luizf0120/database-migration-schema-temporary-holding/artilharia/corte_cunha.png

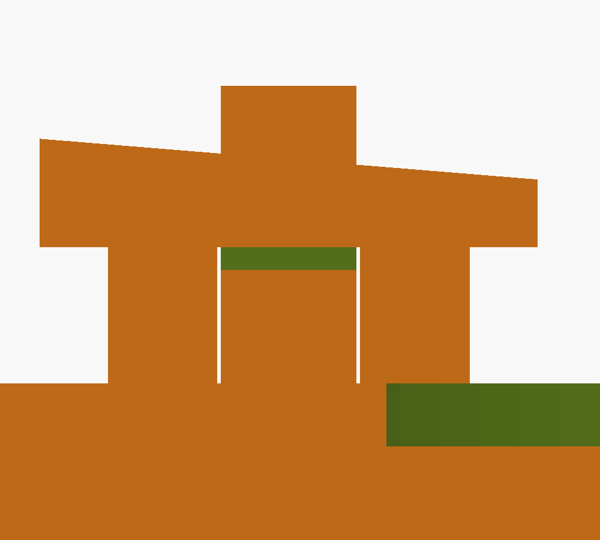
artilharia/corte_cunha.png
