luizf0120/database-migration-schema-temporary-holding/artilharia/detalhe_elevacao.png

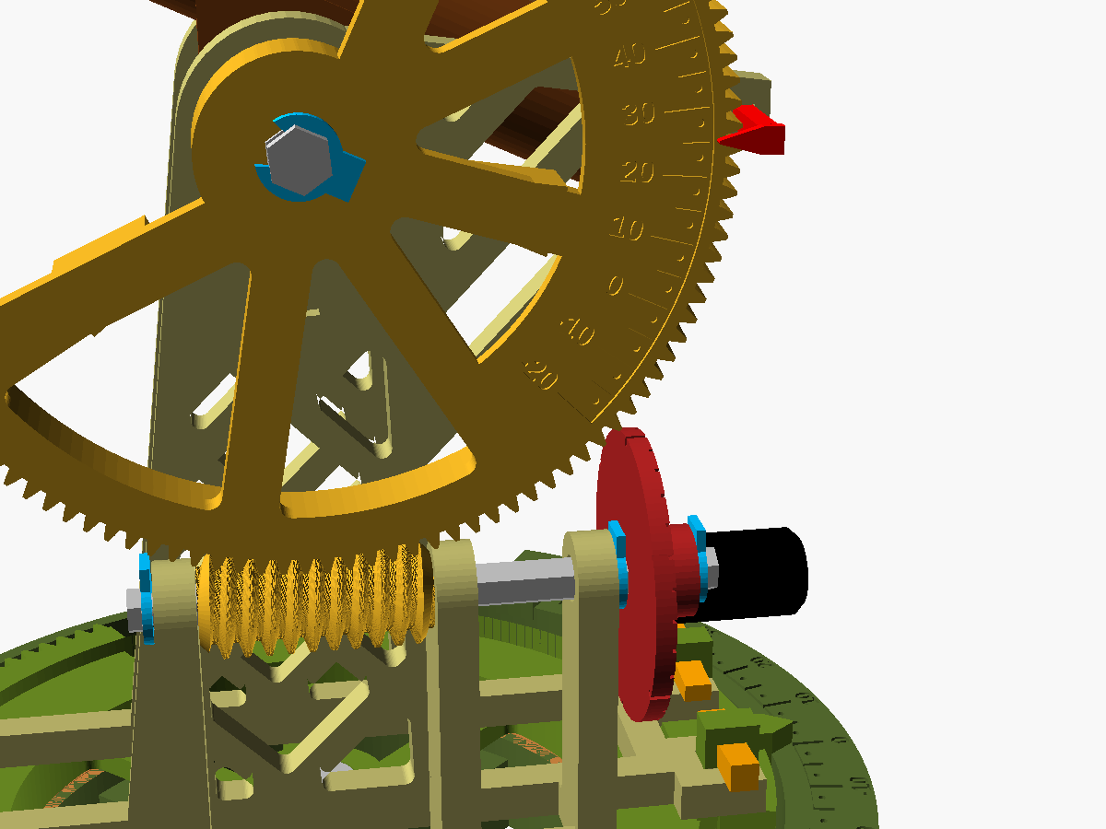
artilharia/detalhe_elevacao.png
