luizf0120/database-migration-schema-temporary-holding/artilharia/numeros_avulsos.png

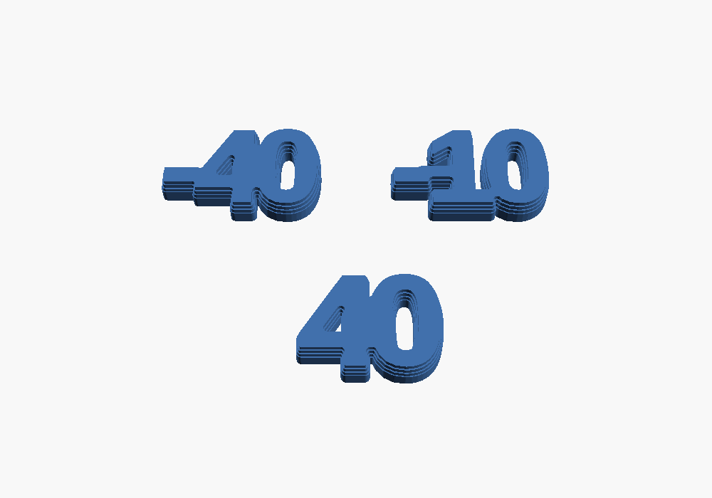
artilharia/numeros_avulsos.png
