luizf0120/database-migration-schema-temporary-holding/artilharia/rolamento_explodido.png

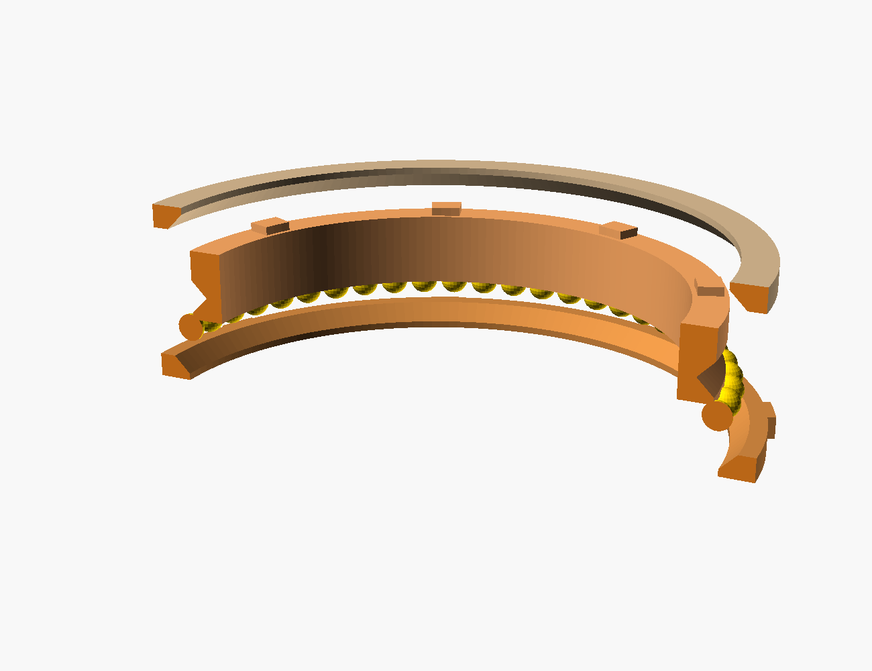
artilharia/rolamento_explodido.png
