luizf0120/database-migration-schema-temporary-holding/artilharia/stl/numeros_avulsos.stl

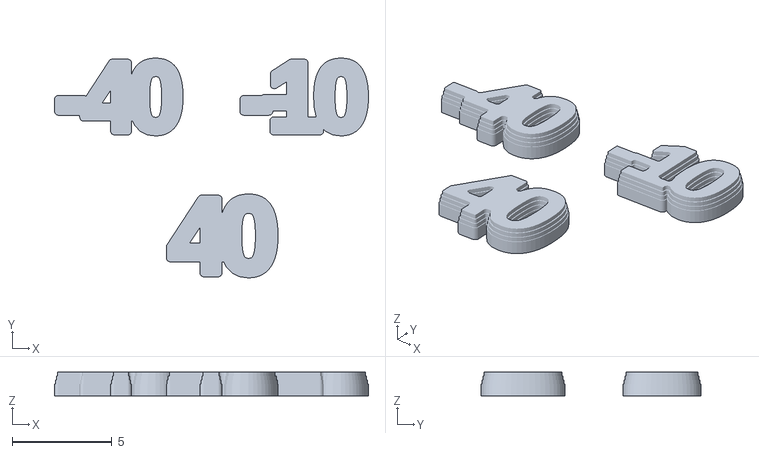
[picture p18: CAD file, 2026-11-08]
artilharia/stl/numeros_avulsos.stl
15.7 x 11.0 x 1.20
