luizf0120/database-migration-schema-temporary-holding/artilharia/stl/numeros_az.stl

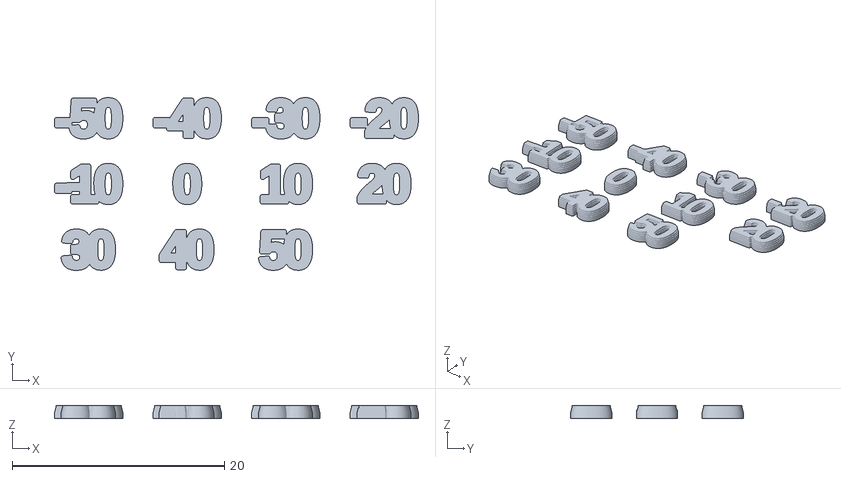
[picture p19: CAD file, 2026-11-06]
artilharia/stl/numeros_az.stl
34.3 x 16.3 x 1.20
