luizf0120/database-migration-schema-temporary-holding/artilharia/stl/numeros_el.stl

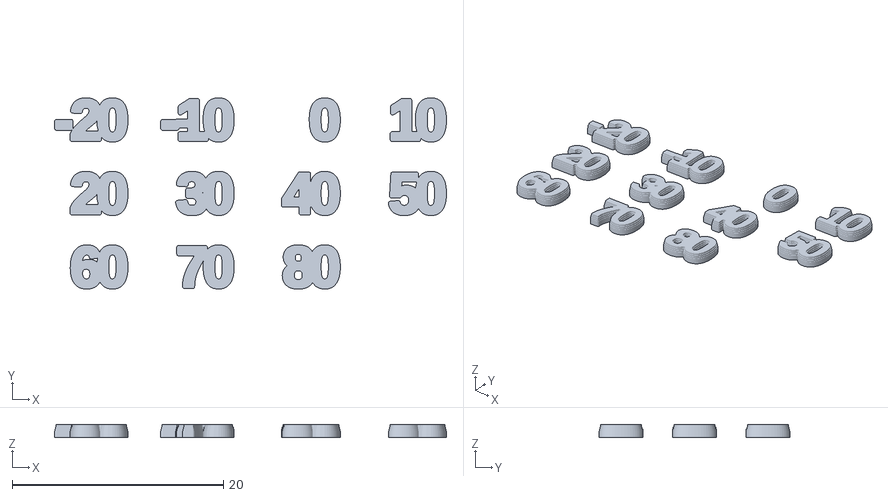
[picture p20: CAD file, 2026-11-06]
artilharia/stl/numeros_el.stl
37.1 x 18.1 x 1.20
