luizf0120/database-migration-schema-temporary-holding/artilharia/stl/regua_el.stl

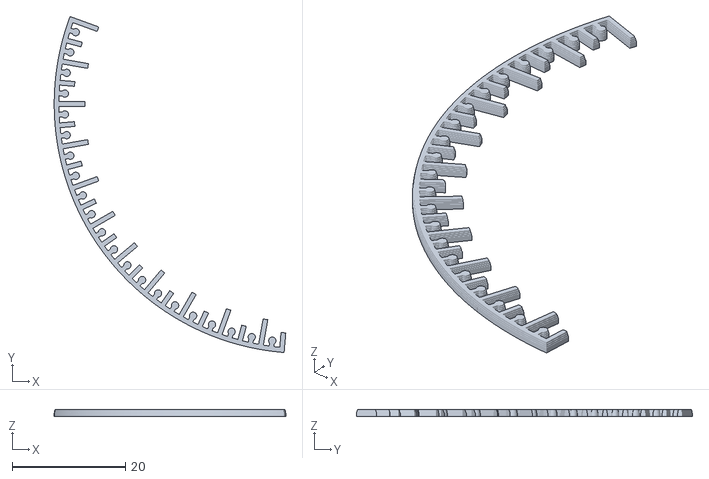
[picture p21: CAD file, 2026-11-06]
artilharia/stl/regua_el.stl
41.0 x 59.5 x 1.20
