luizf0120/database-migration-schema-temporary-holding/artilharia/stl/regua_az.stl

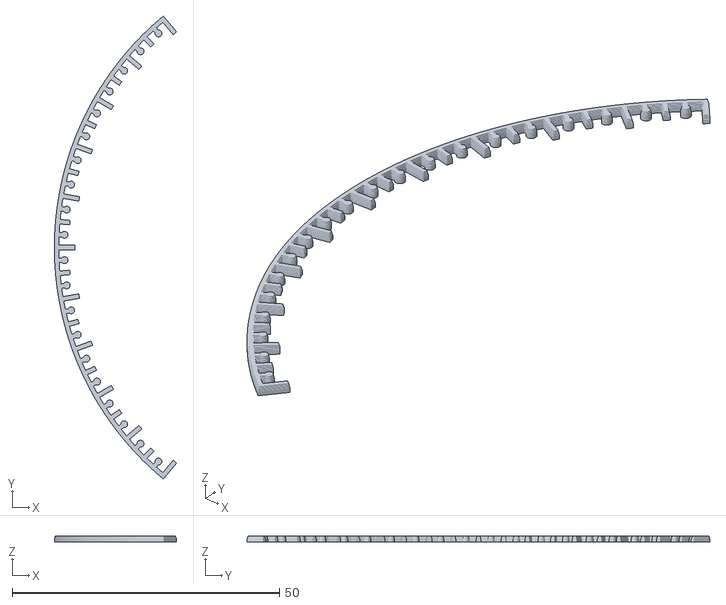
[picture p22: CAD file, 2026-11-06]
artilharia/stl/regua_az.stl
22.9 x 86.6 x 1.20
