luizf0120/database-migration-schema-temporary-holding/artilharia/stl/calco_ponteiro.stl

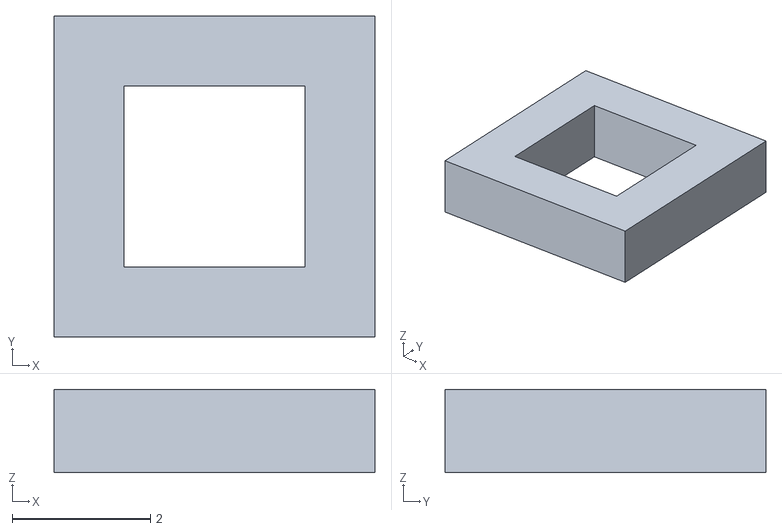
[picture p23: CAD file, 2026-11-06]
artilharia/stl/calco_ponteiro.stl
4.64 x 4.64 x 1.20
