luizf0120/database-migration-schema-temporary-holding/artilharia/stl/anel_reparo.stl

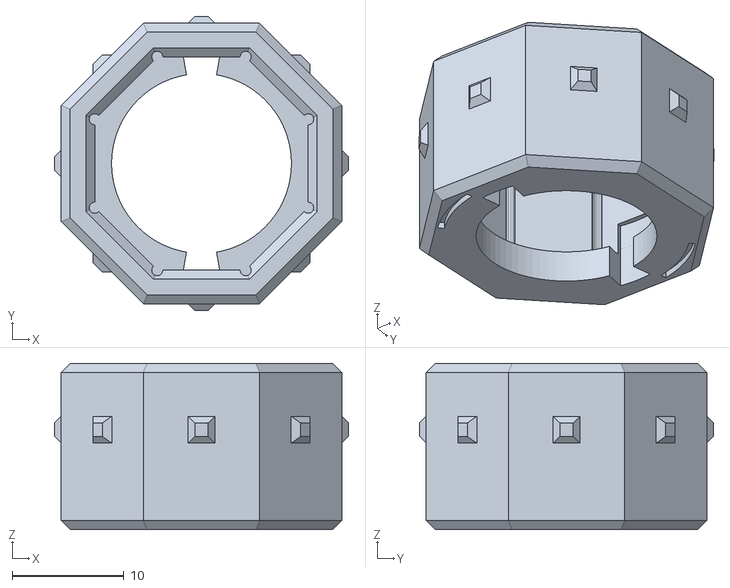
[picture p24: CAD file, 2026-11-05]
artilharia/stl/anel_reparo.stl
26.3 x 26.3 x 14.9
