luizf0120/database-migration-schema-temporary-holding/artilharia/stl/travessa_carro.stl

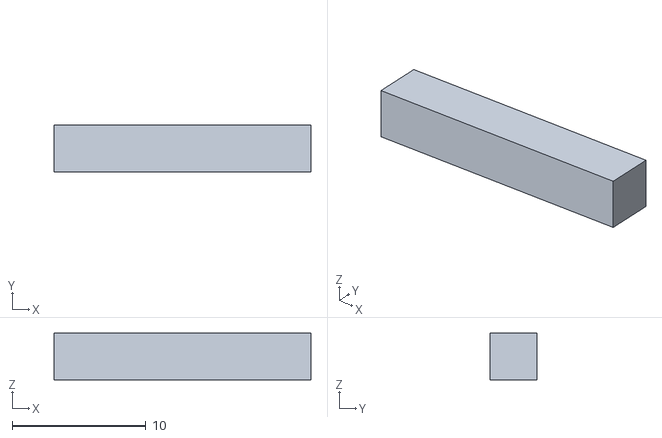
[picture p25: CAD file, 2026-11-04]
artilharia/stl/travessa_carro.stl
19.2 x 3.48 x 3.48
