luizf0120/database-migration-schema-temporary-holding/artilharia/stl/culatra.stl

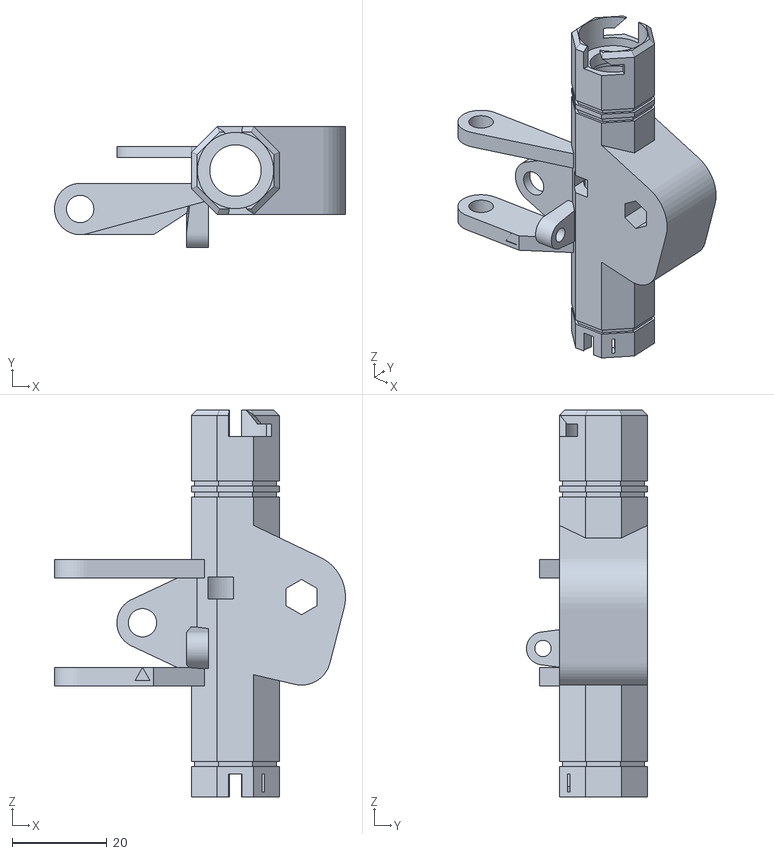
[picture p26: CAD file, 2026-11-03]
artilharia/stl/culatra.stl
61.3 x 25.5 x 81.6
