luizf0120/database-migration-schema-temporary-holding/artilharia/stl/carro.stl

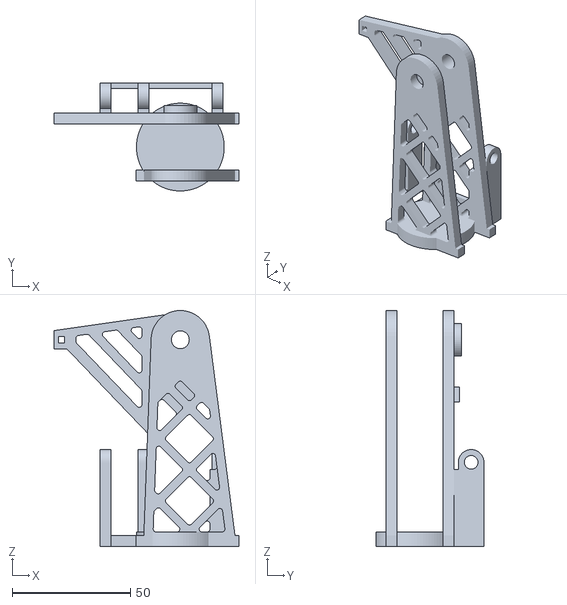
[picture p27: CAD file, 2026-11-03]
artilharia/stl/carro.stl
78.1 x 45.6 x 99.7
