luizf0120/database-migration-schema-temporary-holding/artilharia/stl/eixo_pinhao.stl

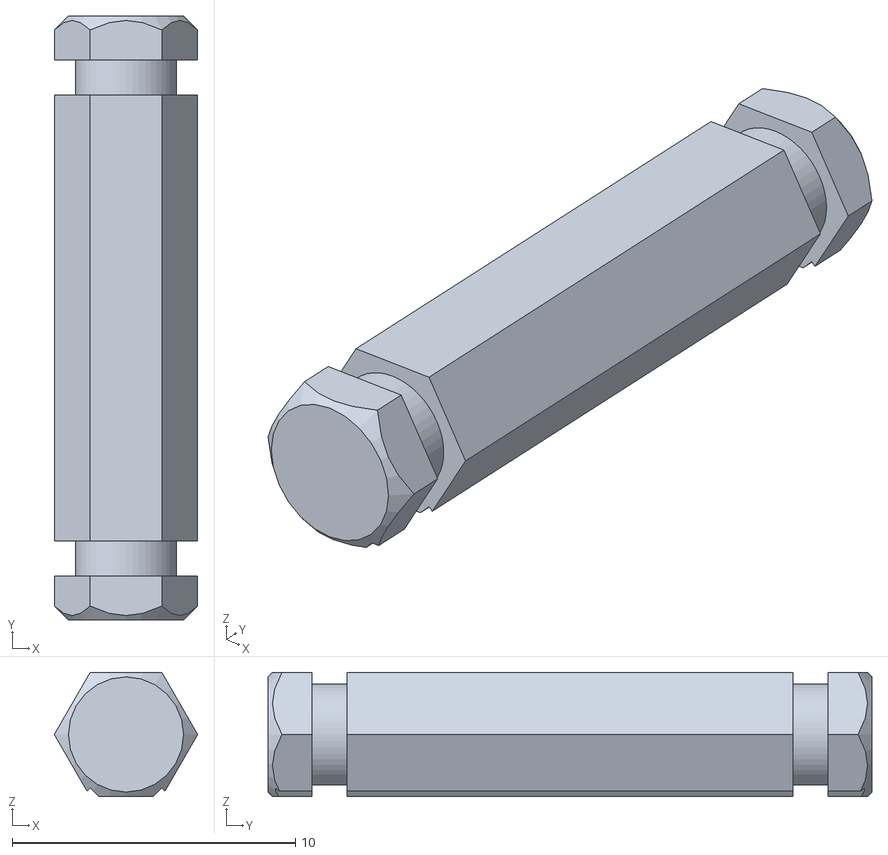
[picture p28: CAD file, 2026-11-03]
artilharia/stl/eixo_pinhao.stl
5.07 x 21.3 x 4.39
