luizf0120/database-migration-schema-temporary-holding/artilharia/stl/cano.stl

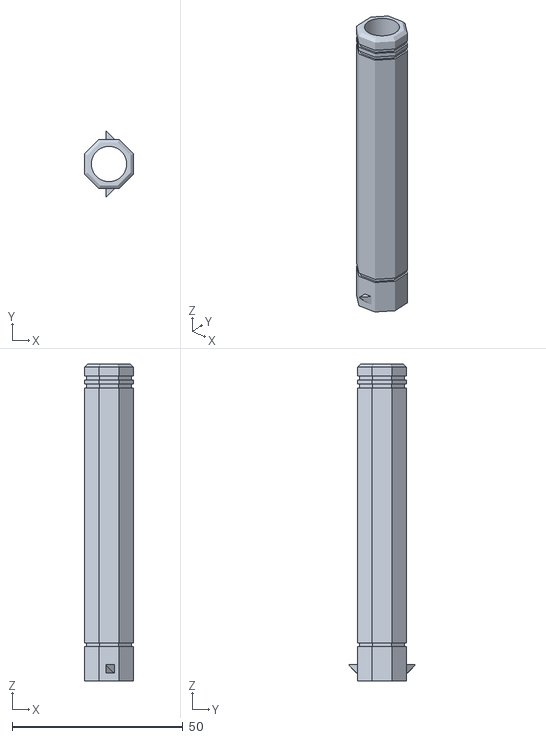
[picture p29: CAD file, 2026-11-03]
artilharia/stl/cano.stl
14.4 x 19.3 x 92.8
