luizf0120/database-migration-schema-temporary-holding/artilharia/stl/amortecedor.stl

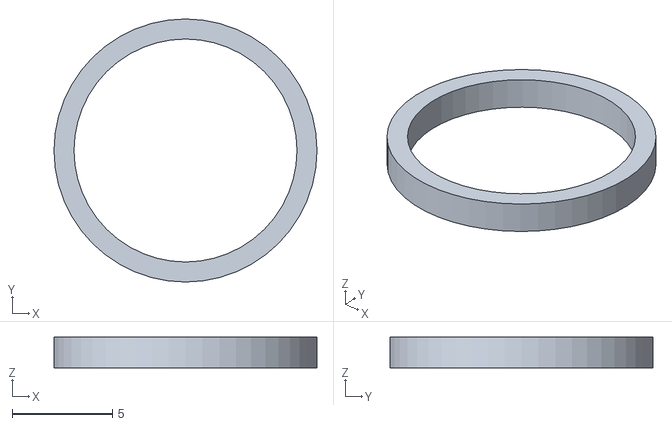
[picture p30: CAD file, 2026-11-03]
artilharia/stl/amortecedor.stl
13.1 x 13.1 x 1.55
