luizf0120/database-migration-schema-temporary-holding/artilharia/stl/ponteiro_el.stl

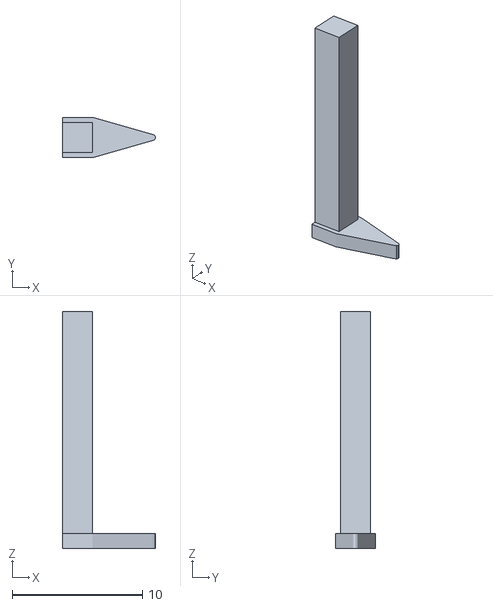
[picture p31: CAD file, 2026-11-03]
artilharia/stl/ponteiro_el.stl
7.15 x 3.09 x 18.2
