luizf0120/database-migration-schema-temporary-holding/artilharia/stl/pino_pivo.stl

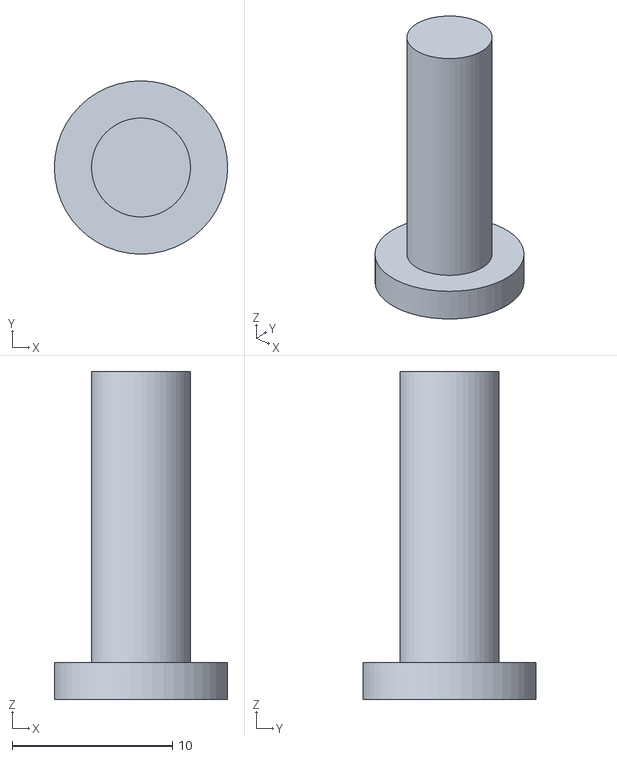
[picture p32: CAD file, 2026-11-03]
artilharia/stl/pino_pivo.stl
10.8 x 10.8 x 20.5
