luizf0120/database-migration-schema-temporary-holding/artilharia/stl/tampa.stl

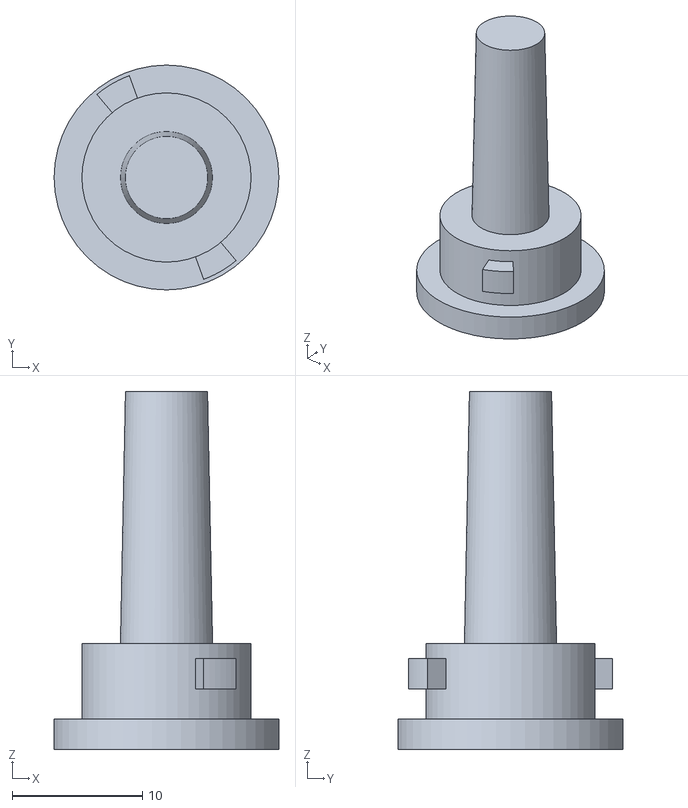
[picture p33: CAD file, 2026-11-03]
artilharia/stl/tampa.stl
17.2 x 17.2 x 27.4
