luizf0120/database-migration-schema-temporary-holding/artilharia/stl/pino_gatilho.stl

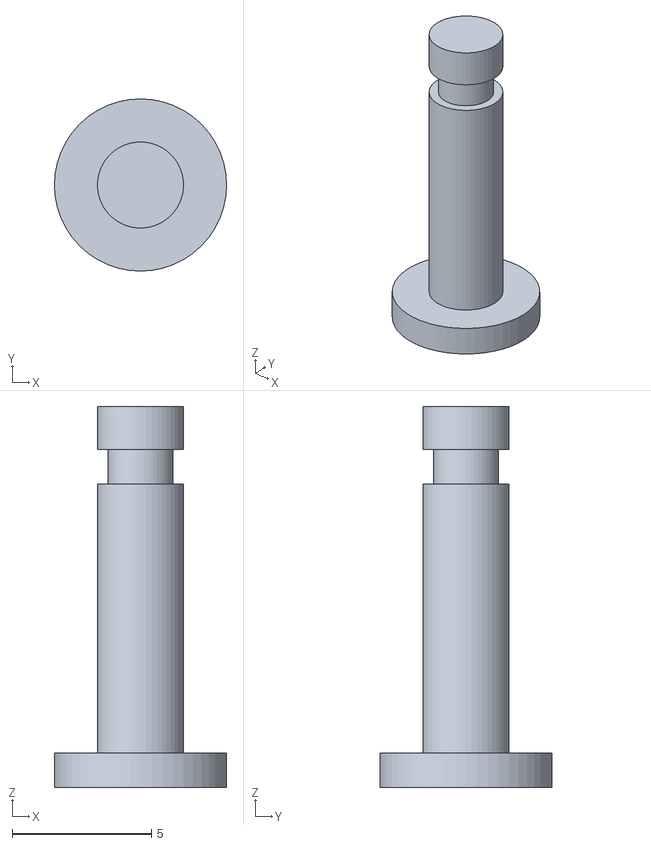
[picture p34: CAD file, 2026-11-02]
artilharia/stl/pino_gatilho.stl
6.19 x 6.19 x 13.7
