luizf0120/database-migration-schema-temporary-holding/artilharia/stl/eixo_az.stl

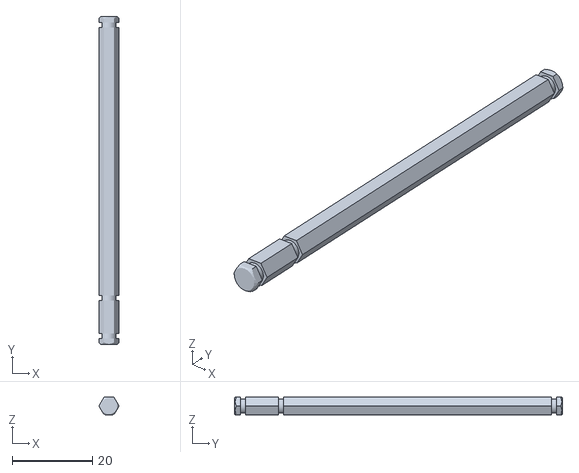
[picture p35: CAD file, 2026-10-31]
artilharia/stl/eixo_az.stl
5.07 x 82.0 x 4.39
