luizf0120/database-migration-schema-temporary-holding/artilharia/stl/eixo_munhao.stl

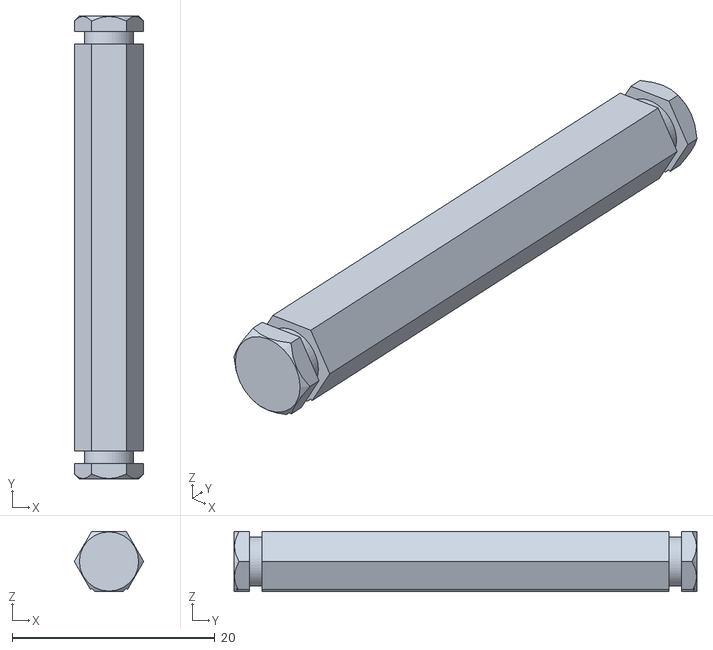
[picture p36: CAD file, 2026-10-31]
artilharia/stl/eixo_munhao.stl
6.85 x 45.7 x 5.94
