luizf0120/database-migration-schema-temporary-holding/artilharia/stl/soquete.stl

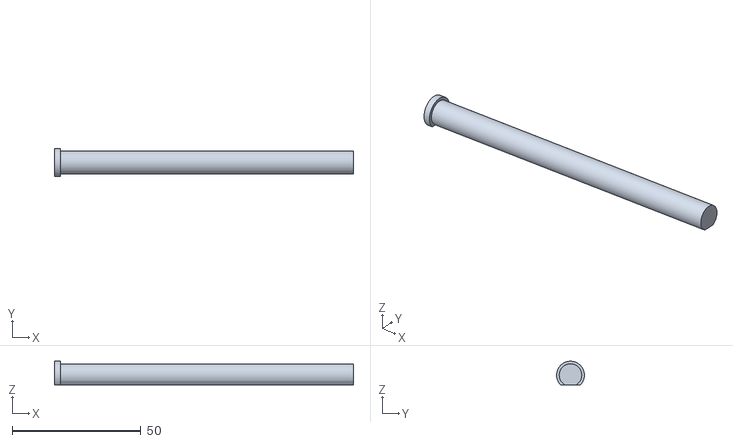
[picture p37: CAD file, 2026-10-31]
artilharia/stl/soquete.stl
116.0 x 10.8 x 9.19
