luizf0120/database-migration-schema-temporary-holding/artilharia/stl/eixo_armar.stl

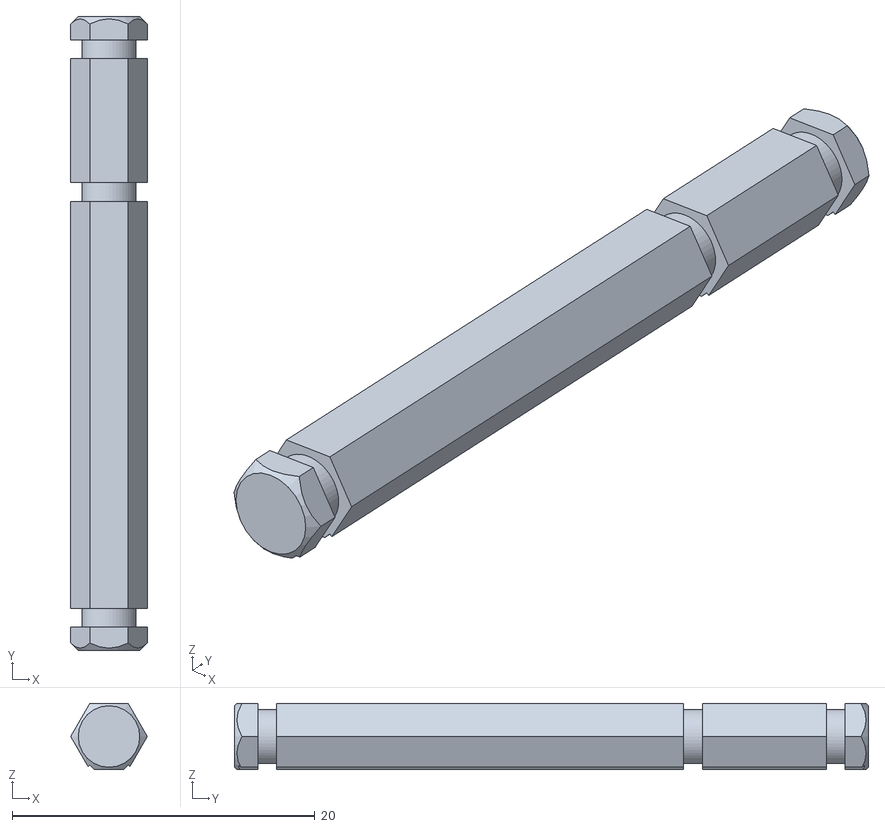
[picture p38: CAD file, 2026-10-31]
artilharia/stl/eixo_armar.stl
5.07 x 41.9 x 4.39
