luizf0120/database-migration-schema-temporary-holding/artilharia/stl/gatilho.stl

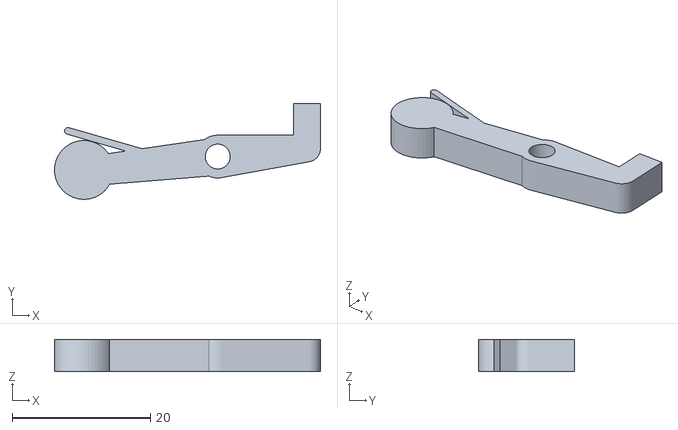
[picture p39: CAD file, 2026-10-31]
artilharia/stl/gatilho.stl
38.4 x 13.8 x 4.64
