luizf0120/database-migration-schema-temporary-holding/artilharia/stl/eixo_el.stl

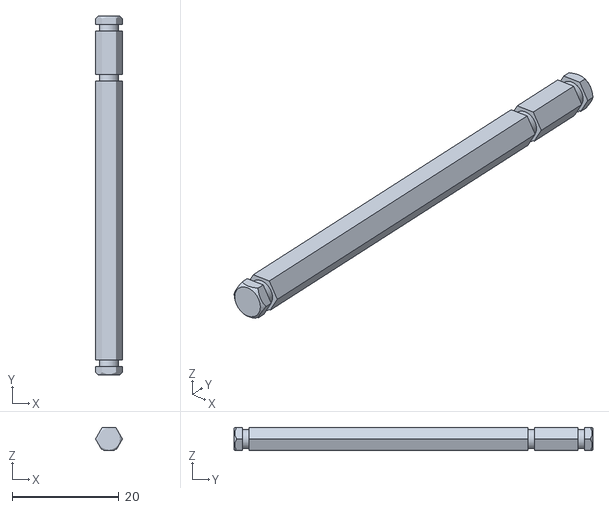
[picture p40: CAD file, 2026-10-31]
artilharia/stl/eixo_el.stl
5.07 x 67.3 x 4.39
