luizf0120/database-migration-schema-temporary-holding/artilharia/stl/ponteiro_az.stl

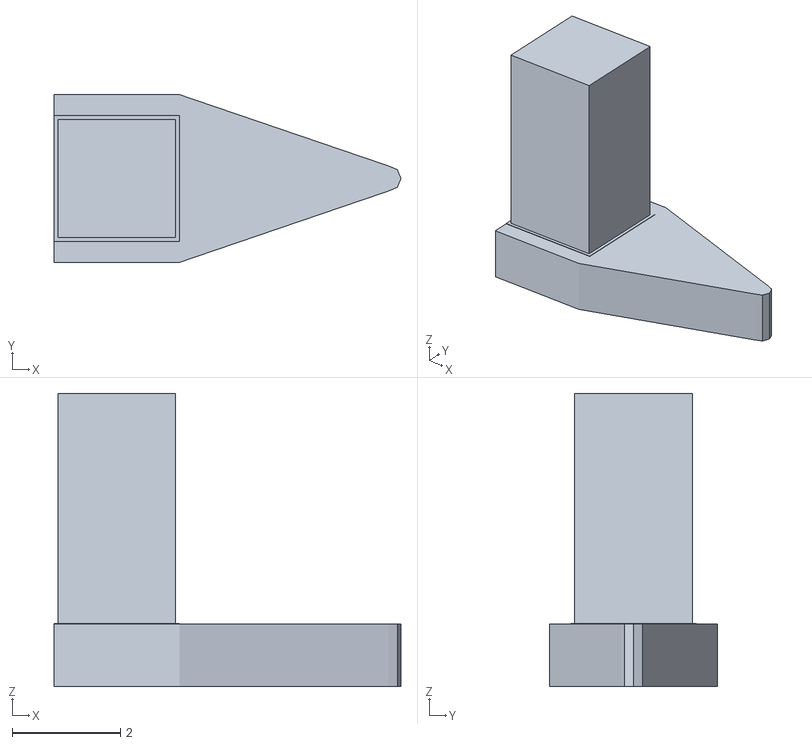
[picture p41: CAD file, 2026-10-31]
artilharia/stl/ponteiro_az.stl
6.40 x 3.09 x 5.41
