luizf0120/database-migration-schema-temporary-holding/artilharia/stl/culatra_cima.stl

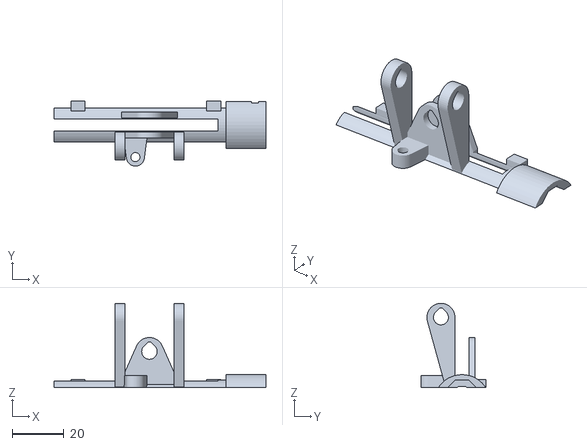
[picture p42: CAD file, 2026-10-30]
artilharia/stl/culatra_cima.stl
81.6 x 25.1 x 32.5
