luizf0120/database-migration-schema-temporary-holding/artilharia/stl/culatra_baixo.stl

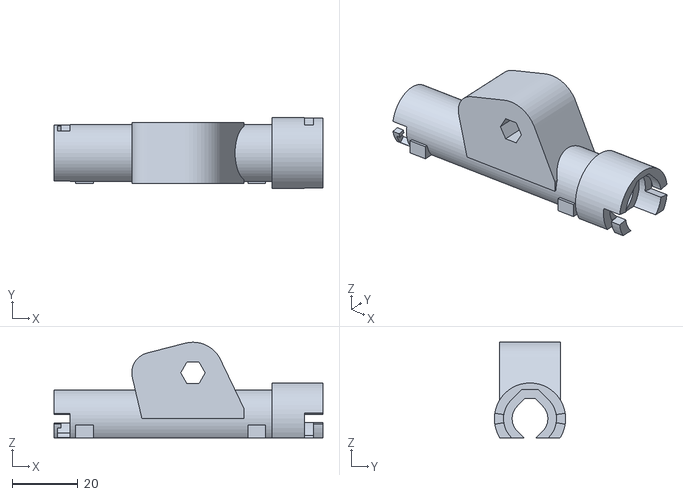
[picture p43: CAD file, 2026-10-30]
artilharia/stl/culatra_baixo.stl
81.6 x 21.6 x 29.0
