luizf0120/database-migration-schema-temporary-holding/artilharia/stl/trava_4.stl

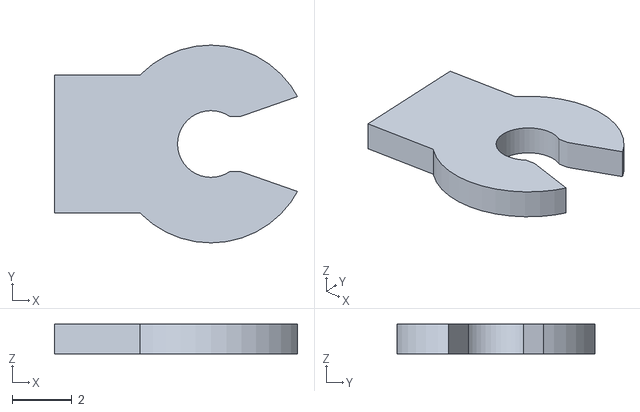
[picture p44: CAD file, 2026-10-25]
artilharia/stl/trava_4.stl
8.17 x 6.65 x 1.00
