luizf0120/database-migration-schema-temporary-holding/artilharia/stl/trava_8.stl

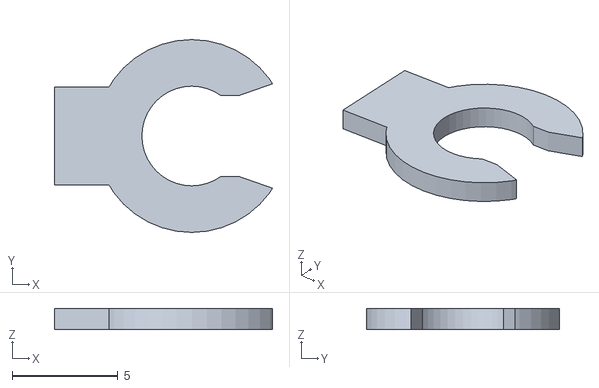
[picture p45: CAD file, 2026-10-25]
artilharia/stl/trava_8.stl
10.3 x 9.12 x 1.00
