luizf0120/database-migration-schema-temporary-holding/artilharia/stl/trava_6.stl

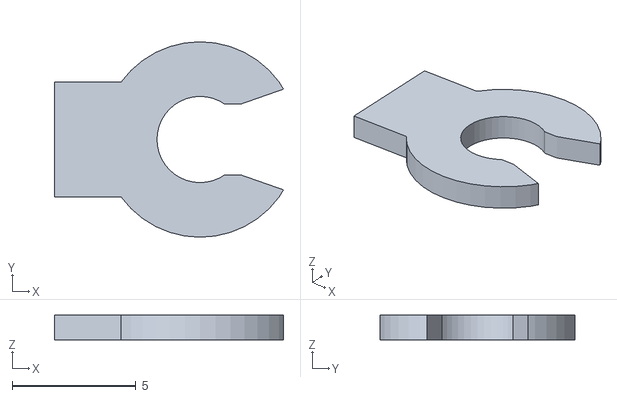
[picture p46: CAD file, 2026-10-25]
artilharia/stl/trava_6.stl
9.24 x 7.89 x 1.00
