luizf0120/database-migration-schema-temporary-holding/artilharia/stl/roda_el.stl

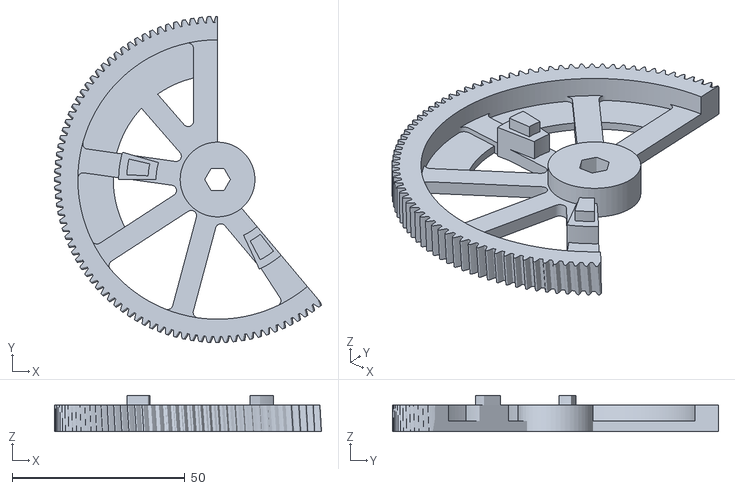
[picture p47: CAD file, 2026-10-24]
artilharia/stl/roda_el.stl
77.2 x 94.3 x 10.4
