luizf0120/database-migration-schema-temporary-holding/artilharia/stl/manivela_el.stl

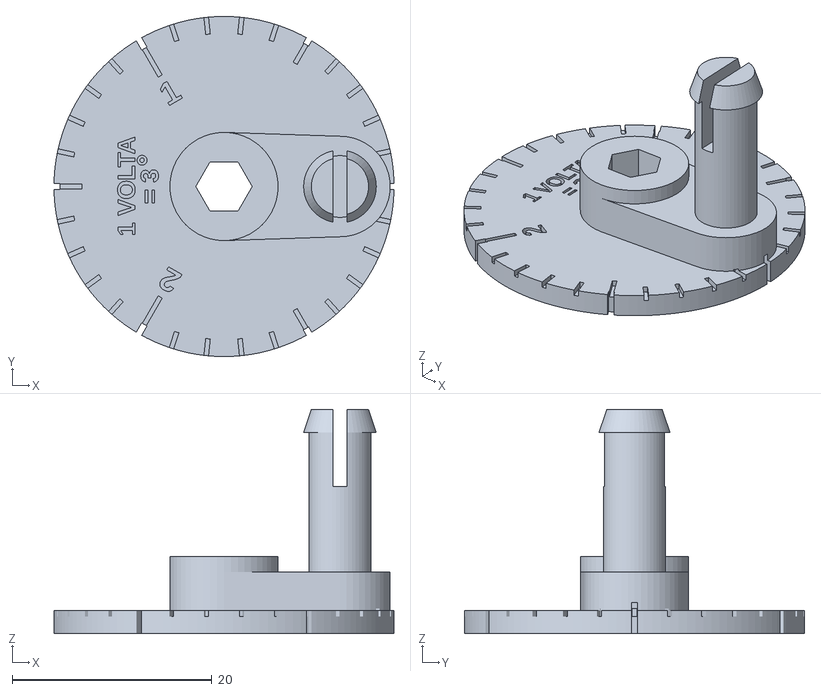
[picture p48: CAD file, 2026-10-24]
artilharia/stl/manivela_el.stl
34.0 x 34.0 x 22.4
