luizf0120/database-migration-schema-temporary-holding/artilharia/stl/rosca_armar.stl

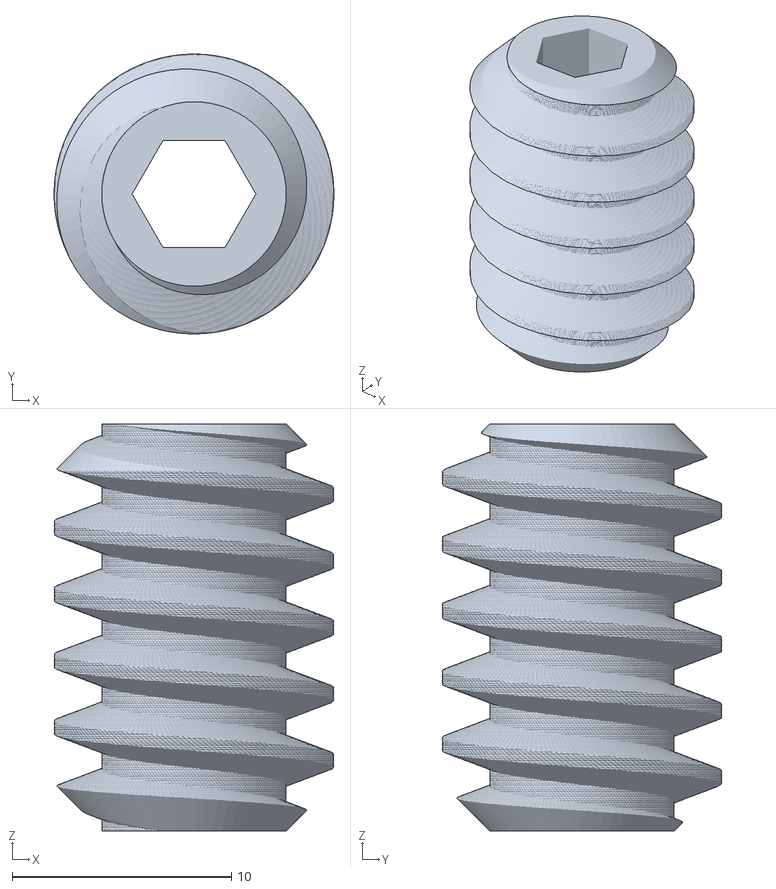
[picture p49: CAD file, 2026-10-24]
artilharia/stl/rosca_armar.stl
12.8 x 12.8 x 18.6
