luizf0120/database-migration-schema-temporary-holding/artilharia/stl/anel_externo_baixo.stl

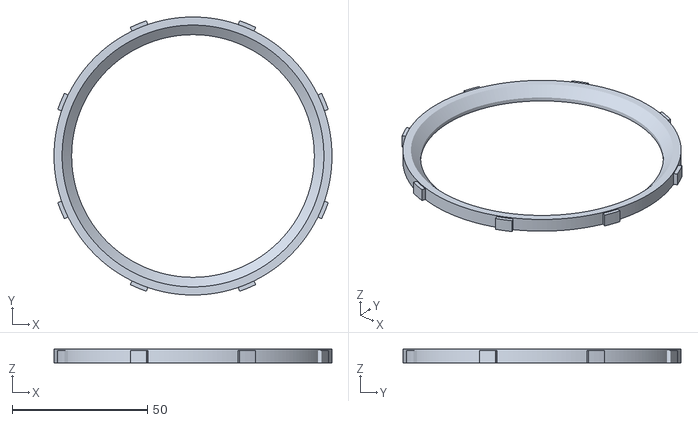
[picture p50: CAD file, 2026-10-24]
artilharia/stl/anel_externo_baixo.stl
102.8 x 102.8 x 5.00
