luizf0120/database-migration-schema-temporary-holding/artilharia/stl/porta_projeteis.stl

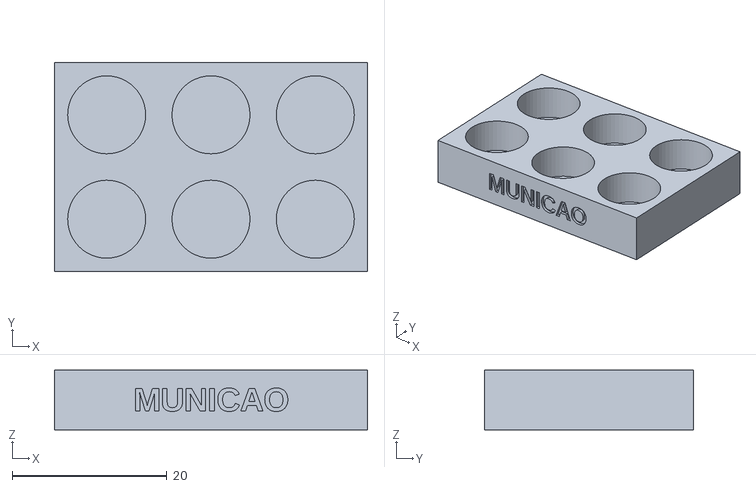
[picture p52: CAD file, 2026-10-24]
artilharia/stl/porta_projeteis.stl
40.4 x 26.9 x 7.73
