luizf0120/database-migration-schema-temporary-holding/artilharia/stl/mesa.stl

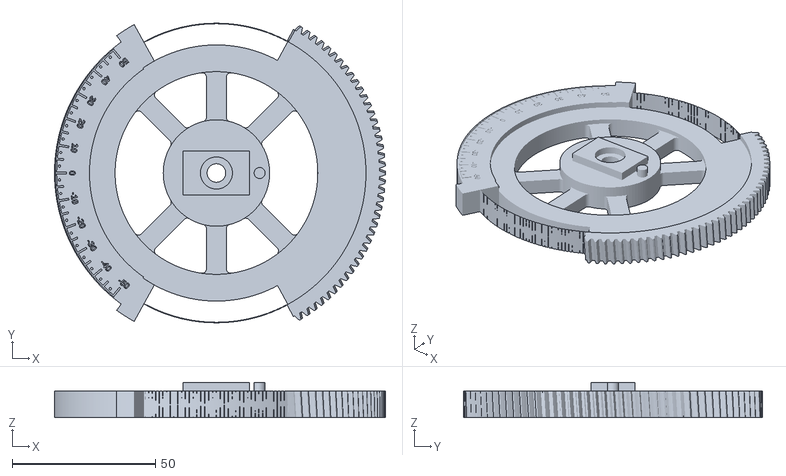
[picture p53: CAD file, 2026-10-24]
artilharia/stl/mesa.stl
115.4 x 104.3 x 12.4
