luizf0120/database-migration-schema-temporary-holding/artilharia/stl/pistao.stl

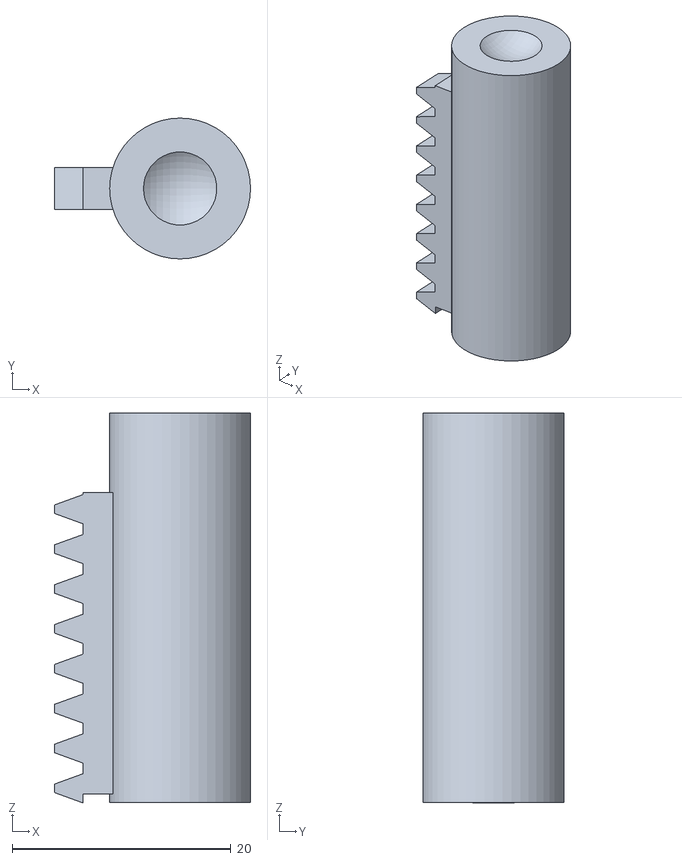
[picture p54: CAD file, 2026-10-24]
artilharia/stl/pistao.stl
17.9 x 12.9 x 35.6
