luizf0120/database-migration-schema-temporary-holding/artilharia/stl/pinhao_armar.stl

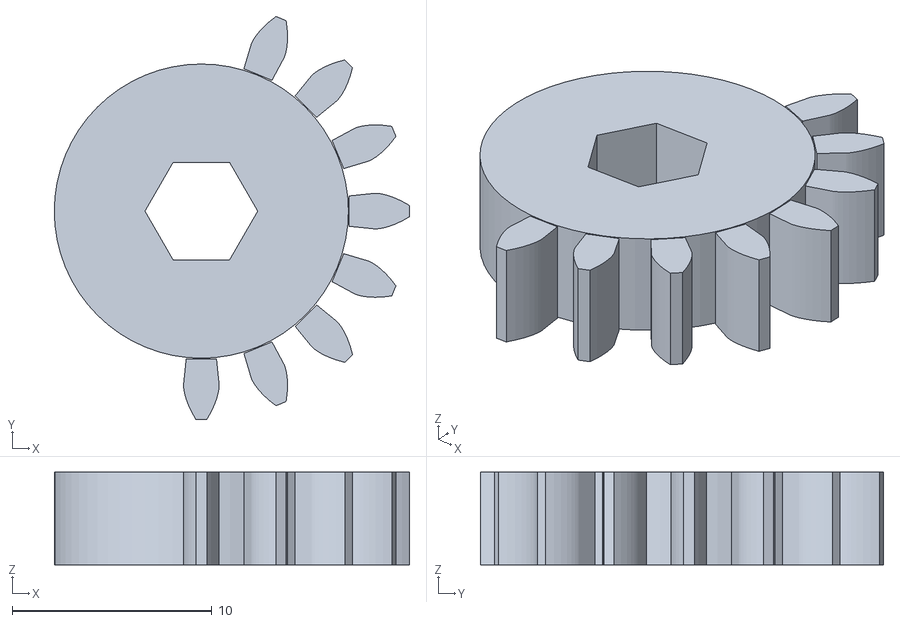
[picture p55: CAD file, 2026-10-24]
artilharia/stl/pinhao_armar.stl
17.8 x 20.2 x 4.64
