luizf0120/database-migration-schema-temporary-holding/artilharia/stl/punho_armar.stl

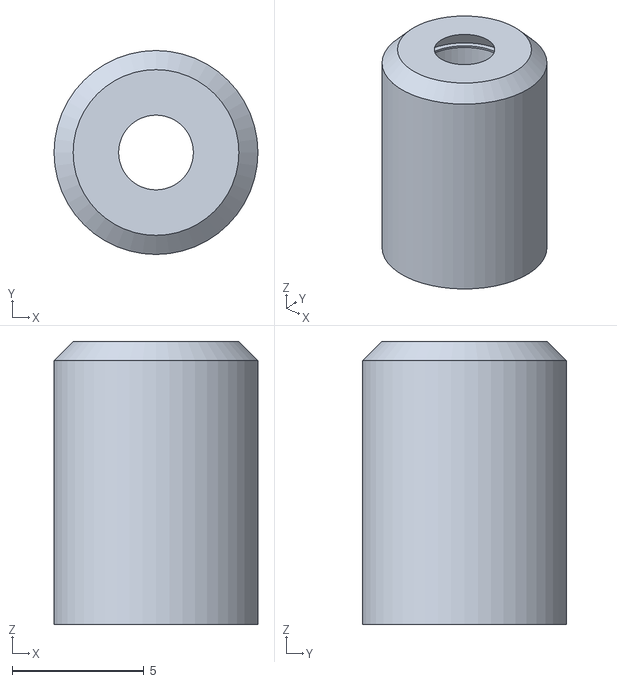
[picture p56: CAD file, 2026-10-24]
artilharia/stl/punho_armar.stl
7.73 x 7.73 x 10.7
