luizf0120/database-migration-schema-temporary-holding/artilharia/stl/coroa_armar.stl

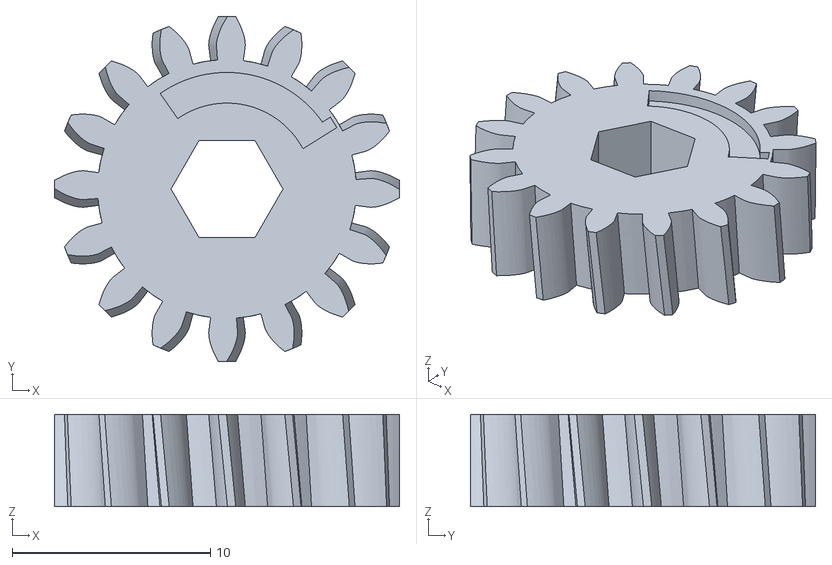
[picture p57: CAD file, 2026-10-24]
artilharia/stl/coroa_armar.stl
17.4 x 17.4 x 4.64
