luizf0120/database-migration-schema-temporary-holding/artilharia/stl/volante_armar.stl

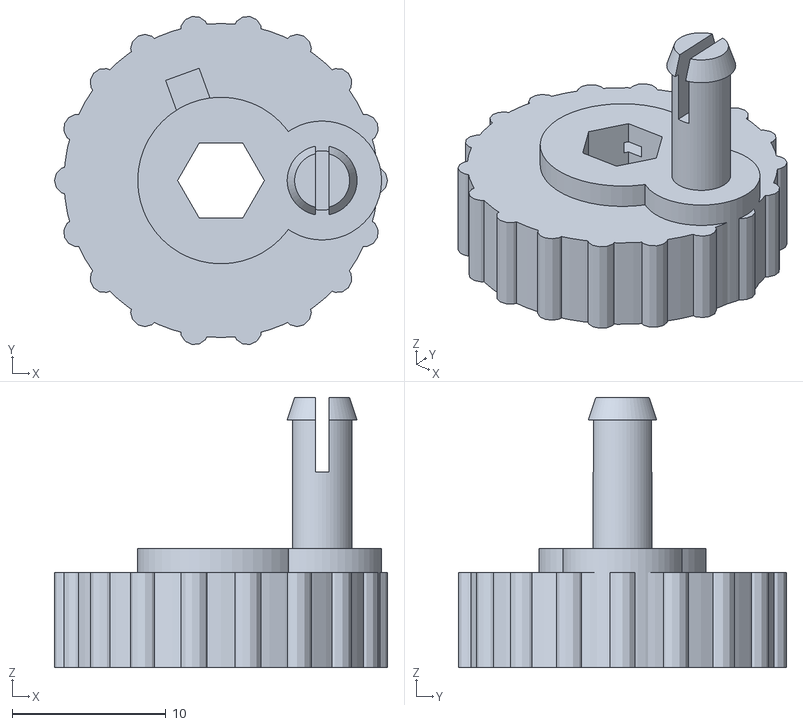
[picture p58: CAD file, 2026-10-24]
artilharia/stl/volante_armar.stl
21.6 x 21.3 x 17.6
