luizf0120/database-migration-schema-temporary-holding/artilharia/stl/projetil.stl

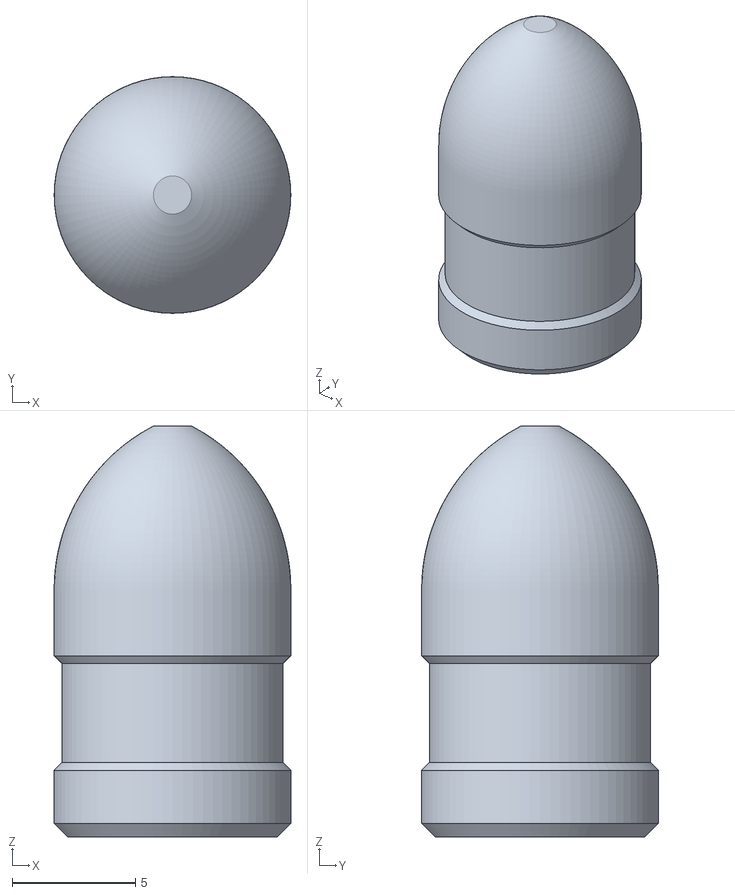
[picture p59: CAD file, 2026-10-24]
artilharia/stl/projetil.stl
9.60 x 9.60 x 16.7
