luizf0120/database-migration-schema-temporary-holding/artilharia/stl/projetil_meio.stl

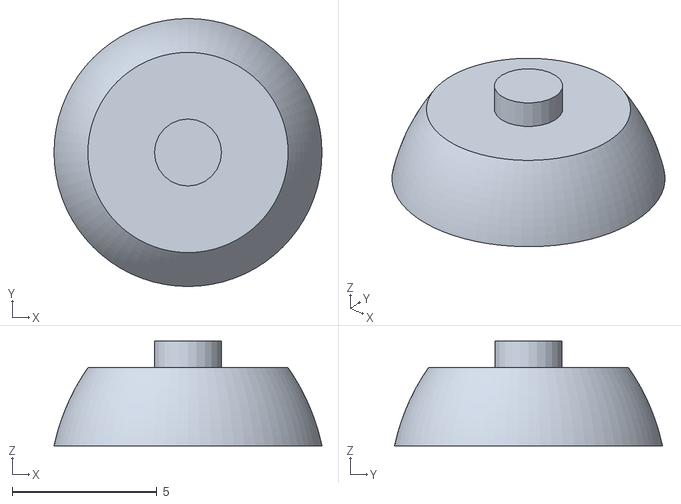
[picture p60: CAD file, 2026-10-24]
artilharia/stl/projetil_meio.stl
9.27 x 9.27 x 3.63
