luizf0120/database-migration-schema-temporary-holding/artilharia/stl/projetil_anel.stl

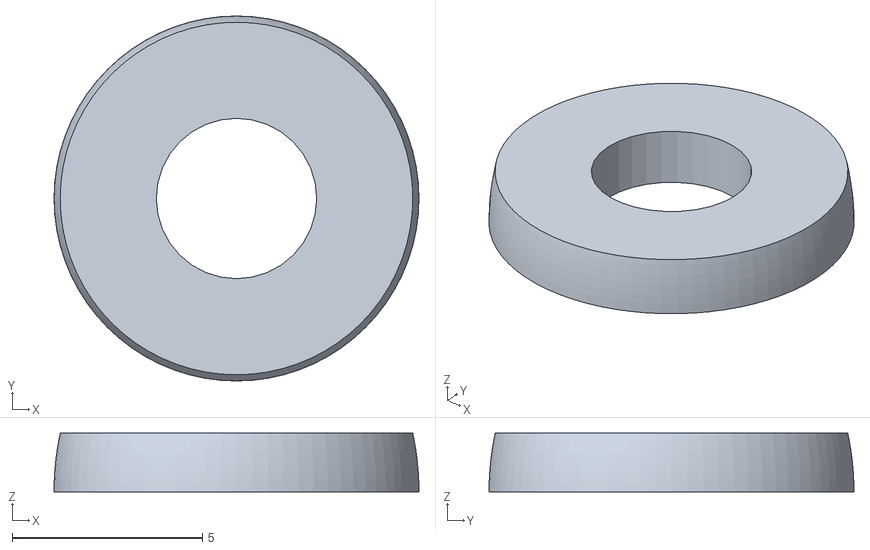
[picture p61: CAD file, 2026-10-24]
artilharia/stl/projetil_anel.stl
9.60 x 9.60 x 1.55
