luizf0120/database-migration-schema-temporary-holding/artilharia/stl/projetil_ponta.stl

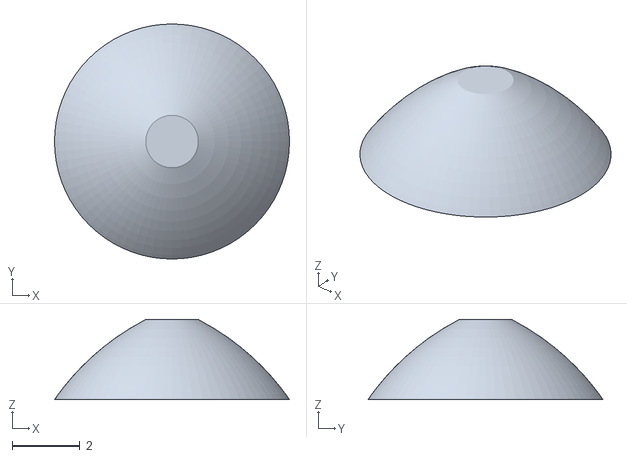
[picture p62: CAD file, 2026-10-24]
artilharia/stl/projetil_ponta.stl
6.92 x 6.92 x 2.36
