luizf0120/database-migration-schema-temporary-holding/artilharia/stl/projetil_corpo.stl

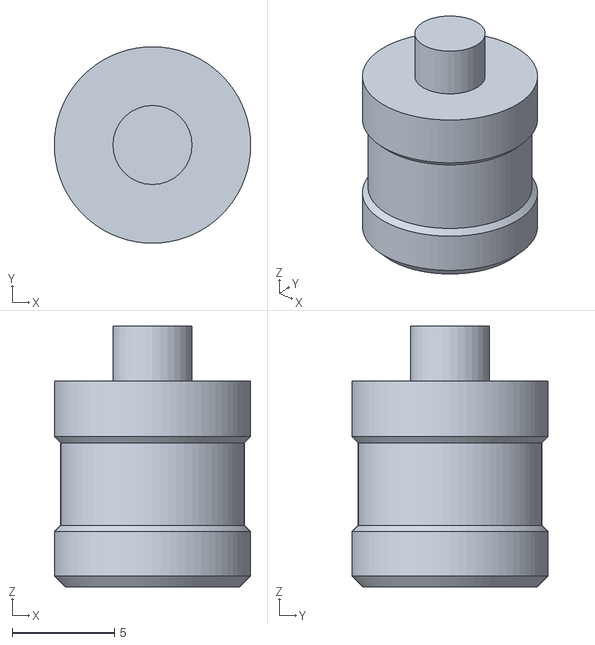
[picture p63: CAD file, 2026-10-24]
artilharia/stl/projetil_corpo.stl
9.60 x 9.60 x 12.8
