luizf0120/database-migration-schema-temporary-holding/artilharia/stl/rosca_el.stl

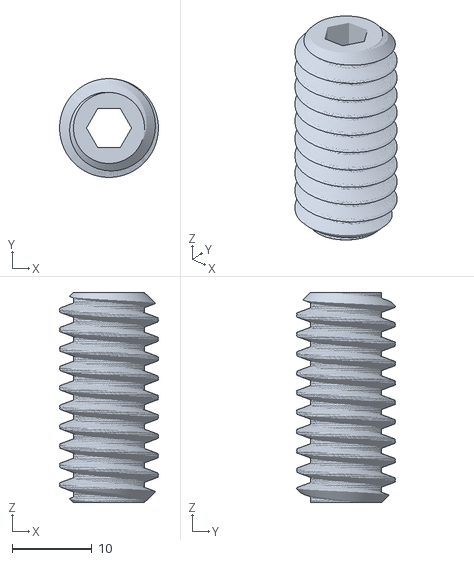
[picture p64: CAD file, 2026-10-24]
artilharia/stl/rosca_el.stl
12.4 x 12.4 x 26.3
