luizf0120/database-migration-schema-temporary-holding/artilharia/stl/anel_interno.stl

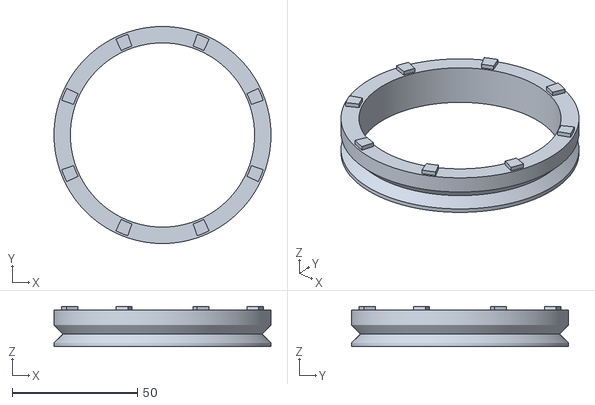
[picture p65: CAD file, 2026-10-24]
artilharia/stl/anel_interno.stl
86.5 x 86.5 x 16.0
