luizf0120/database-migration-schema-temporary-holding/artilharia/stl/rosca_az.stl

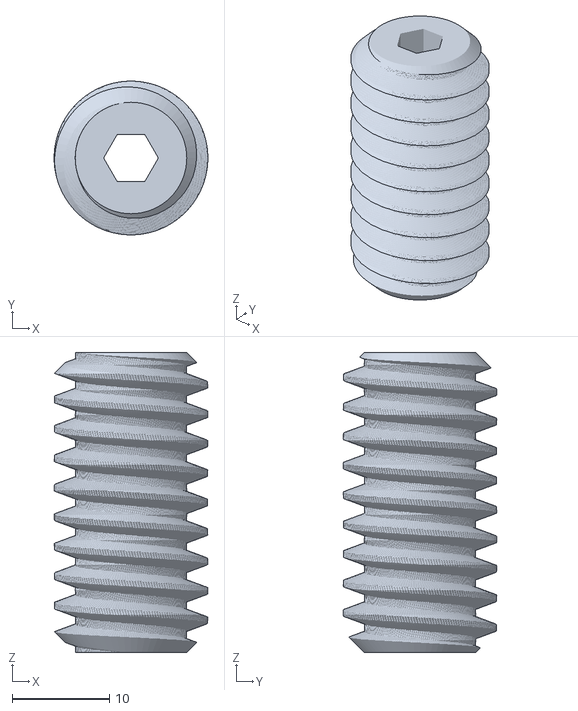
[picture p66: CAD file, 2026-10-24]
artilharia/stl/rosca_az.stl
15.9 x 15.9 x 30.9
