luizf0120/database-migration-schema-temporary-holding/artilharia/stl/base.stl

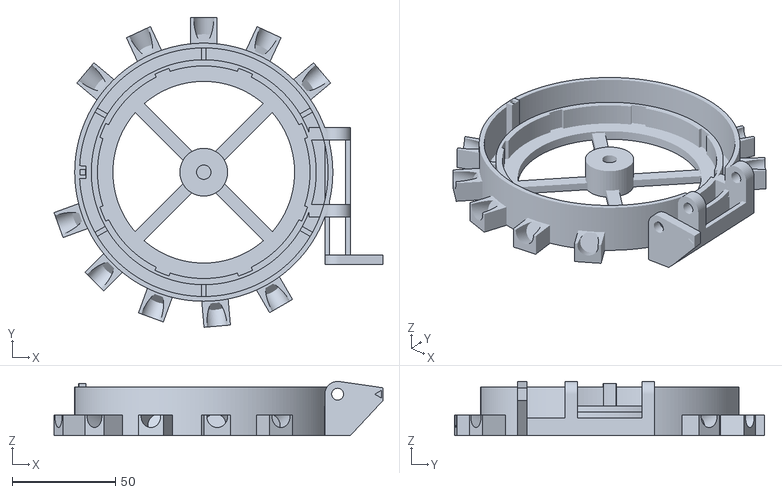
[picture p67: CAD file, 2026-10-24]
artilharia/stl/base.stl
159.7 x 150.3 x 26.3
