luizf0120/database-migration-schema-temporary-holding/artilharia/stl/punho.stl

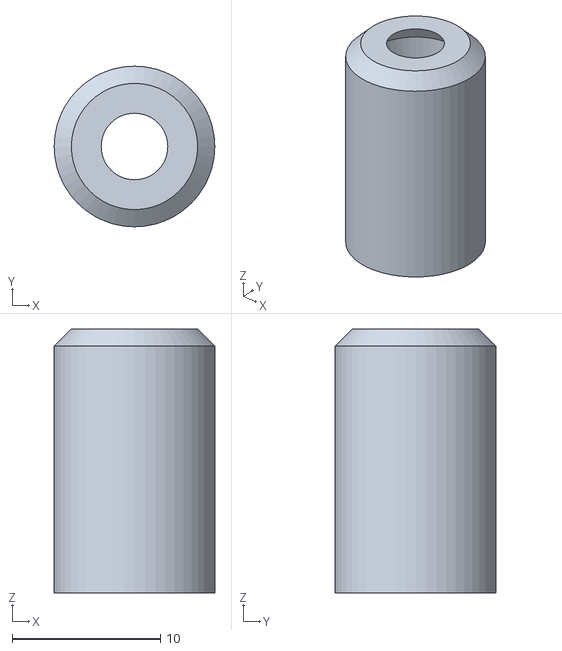
[picture p68: CAD file, 2026-10-24]
artilharia/stl/punho.stl
10.8 x 10.8 x 17.8
