luizf0120/database-migration-schema-temporary-holding/artilharia/stl/anel_pista_mesa.stl

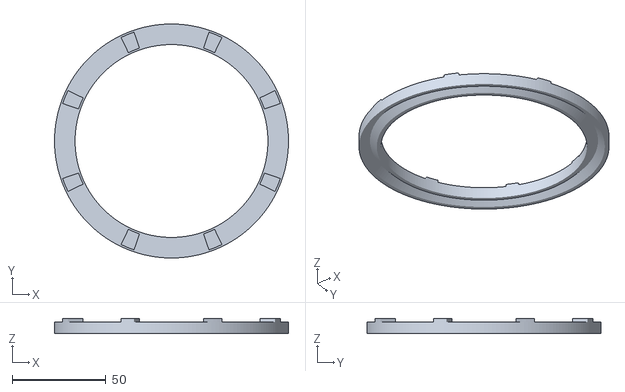
[picture p69: CAD file, 2026-10-24]
artilharia/stl/anel_pista_mesa.stl
125.0 x 125.0 x 7.80
