luizf0120/database-migration-schema-temporary-holding/artilharia/stl/anel_pista_base.stl

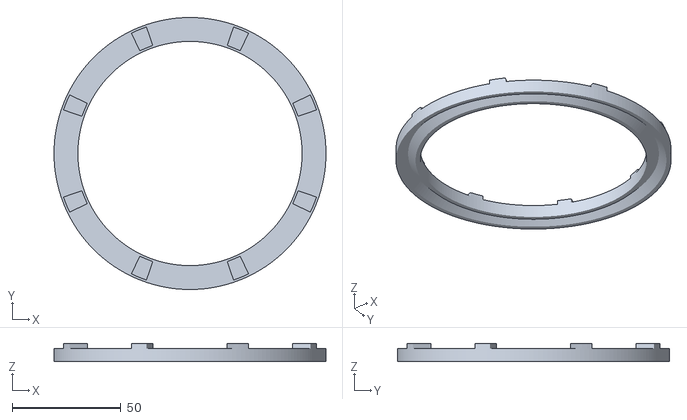
[picture p70: CAD file, 2026-10-24]
artilharia/stl/anel_pista_base.stl
125.0 x 125.0 x 8.50
