luizf0120/database-migration-schema-temporary-holding/artilharia/stl/cunha.stl

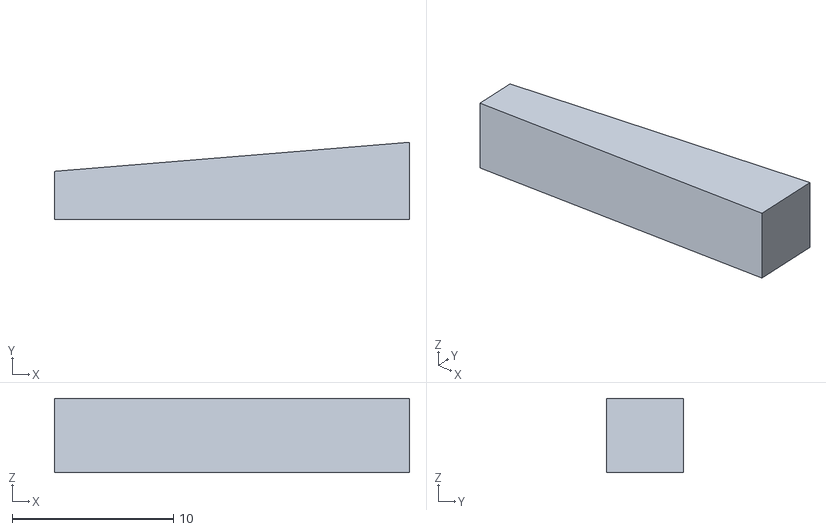
[picture p71: CAD file, 2026-10-24]
artilharia/stl/cunha.stl
22.0 x 4.80 x 4.60
