luizf0120/database-migration-schema-temporary-holding/artilharia/stl/rebite.stl

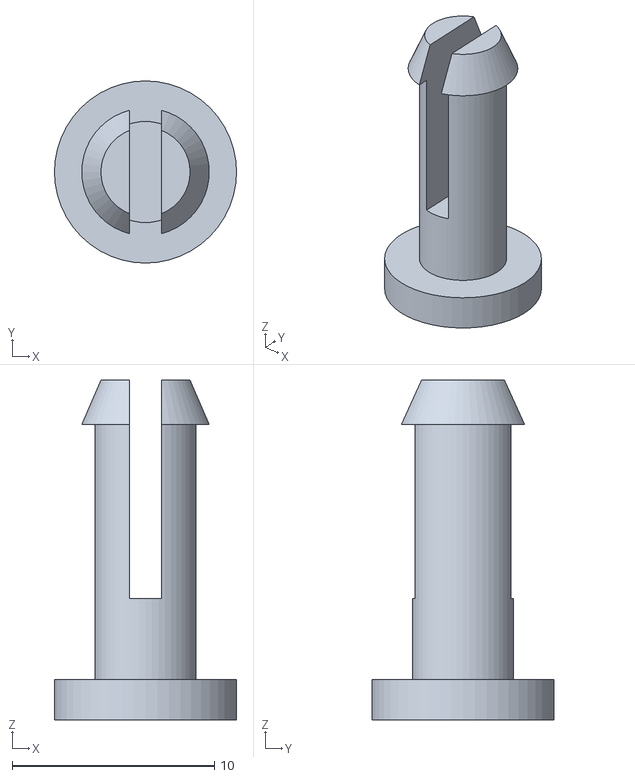
[picture p72: CAD file, 2026-10-22]
artilharia/stl/rebite.stl
9.00 x 9.00 x 16.8
