luizf0120/database-migration-schema-temporary-holding/artilharia/stl/manivela_armar.stl

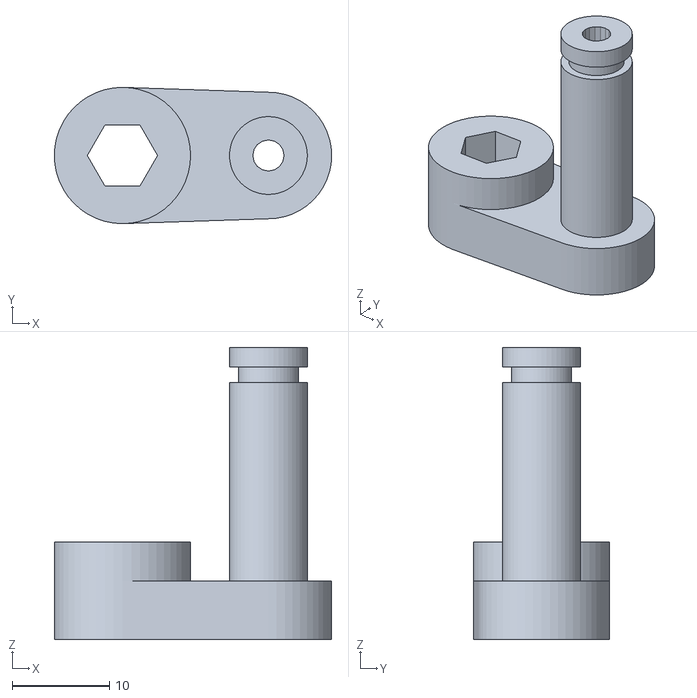
[picture p73: CAD file, 2026-10-22]
artilharia/stl/manivela_armar.stl
28.5 x 14.0 x 30.0
