luizf0120/database-migration-schema-temporary-holding/artilharia/stl/berco.stl

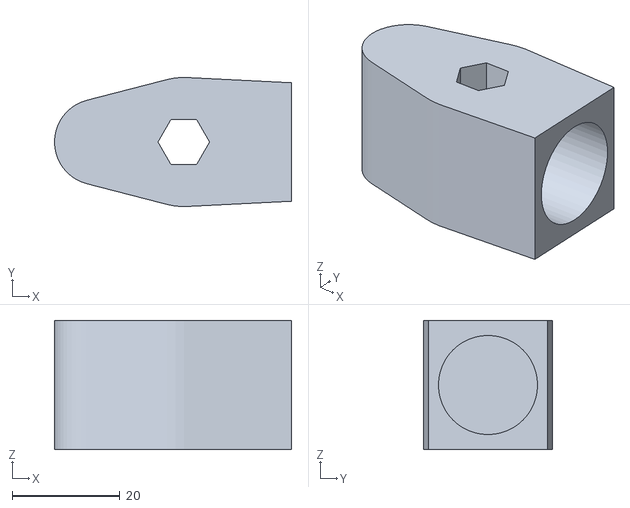
[picture p74: CAD file, 2026-10-22]
artilharia/stl/berco.stl
44.0 x 24.0 x 24.0
