luizf0120/database-migration-schema-temporary-holding/(list of files, cad)

Other CAD files:
artilharia/stl/manivela_az.stl
