luizf0120/database-migration-schema-temporary-holding/(commit log)

2026-09-24 Login com Google restrito a e-mails autorizados no Firebase
    Substitui o login por e-mail/senha pelo login com conta Google e só libera
    o painel para e-mails cadastrados em usuarios_autorizados no Realtime
    Database. Adiciona database.rules.json para aplicar a mesma restrição no
    servidor.
    Claude-Session: https://claude.ai/code/session_01X1thZC78CnoUJ2xLpdo7TD
2026-09-25 Tela de escolha de módulo após o login (ELO / Mov. Sociais)
    Depois do login com Google o operador escolhe entre ELO, que abre o novo
    elo.html (relatório com policiais e viaturas do Firestore), e Mov. Sociais,
    que abre o painel já existente. A escolha fica na sessão para os
    recarregamentos automáticos não voltarem à tela de escolha, e o painel
    ganhou o botão "Módulos" para trocar.
    O elo.html usa a mesma sessão de login e redireciona para o index.html se
    o usuário não estiver logado ou autorizado.
    Claude-Session: https://claude.ai/code/session_011gqq5GfWU7wa3qtoL27YAq
2026-09-25 Botão "Módulos" no topo da página de Mov. Sociais
    Move o botão de voltar para a escolha de módulos da barra de progresso
    para o topo da página, com o mesmo visual do botão do elo.html.
    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
2026-09-25 Texto automático de sobreaviso no ELO
    Com Sobreaviso = Sim, aparece abaixo das opções o texto padrão, que também
    vai para o PDF. Com 1 policial usa "O policial mencionado acima ... acionado";
    com 2 ou mais, "A equipe mencionada acima ... acionada". O texto se atualiza
    quando policiais são escolhidos, adicionados ou removidos.
    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
2026-09-25 Login com e-mail e senha de volta, junto com o Google
    A tela de login volta a ter e-mail/senha (contas do Authentication do
    projeto aesi-movimentos-sociais), além do botão do Google. Contas de
    e-mail/senha ficam liberadas; contas Google continuam precisando estar
    em usuarios_autorizados. A mesma regra vale no elo.html e no
    database.rules.json.
    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
2026-09-25 Mensagens de erro do login mostram o motivo
    O login com senha mostra uma mensagem para cada erro do Firebase junto com
    o código (ex.: auth/invalid-credential). O acesso negado de conta Google
    mostra a chave procurada em usuarios_autorizados. Os erros também vão para
    o console.
    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
2026-09-25 Textos do sobreaviso vêm do Firestore
    Os textos de sobreaviso (1 policial / equipe) saem do código e passam a
    ser lidos de configuracoes/textos_sobreaviso, campos "singular" e
    "plural". Sem o documento, a tela avisa e o PDF não é gerado.
    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
2026-09-25 PDF do ELO gerado como texto (jsPDF) em vez de captura da tela
    O html2pdf gerava o PDF fotografando um molde da página, e o resultado
    saía deslocado, ampliado ou cortado (em branco com a página rolada). Agora
    o PDF é escrito direto com jsPDF: cabeçalho centralizado em negrito, corpo
    em Times 12 justificado, quebra de página automática e texto selecionável.
    O molde oculto do PDF foi removido.
    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
2026-09-25 Texto automático para diligência em que a equipe permaneceu na OPM
    Com "Permaneceu na OPM?" = Sim, a diligência mostra o texto padrão, que
    também vai para o PDF no lugar de "Situação: A equipe permaneceu na OPM.".
    O texto vem de configuracoes/textos_opm (campos "singular" e "plural") e
    concorda com o número de policiais, como o do sobreaviso. O carregamento
    dos textos padrão foi unificado.
    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
2026-09-25 Relógio no término da diligência para informar data e hora
    Um ícone de relógio ao lado de "Término" liga um campo de data acima da
    hora final, para diligências que terminam em outro dia. No PDF o horário
    sai como "22:00 do dia 03/02/2026 às 02:00 do dia 04/02/2026". Sem a
    data preenchida, o relatório avisa e não é gerado.
    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
2026-09-25 Campo DATA do ELO já vem com a data de hoje
    Ao abrir a página, o campo DATA é preenchido com o dia atual no horário
    de Brasília. Clicar nele continua abrindo o seletor para trocar a data.
    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
2026-09-25 Horários obrigatórios nas diligências do ELO
    Antes de gerar o relatório, cada diligência precisa ter horário de início
    e de término (e a data de término, se o relógio estiver ligado). Os campos
    vazios ficam marcados em vermelho, a página rola até o primeiro e um aviso
    lista o que falta em cada diligência. A marca some quando o campo é
    preenchido.
    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
2026-09-25 Cidade e bairro obrigatórios nas diligências fora da OPM
    Diligência em que a equipe não permaneceu na OPM agora exige cidade e
    bairro para gerar o relatório, com a mesma marca vermelha e o mesmo aviso
    dos horários. Campo só com espaços conta como vazio. A marca some ao
    digitar e ao mudar a diligência para "Permaneceu na OPM: Sim".
    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
2026-09-25 Número do BOU obrigatório quando "Gerou BOU?" for Sim
    Diligência fora da OPM com "Gerou BOU? Sim" agora exige o número do BOU
    para gerar o relatório, com a mesma marca vermelha e aviso dos outros
    campos. A marca some ao digitar, ao voltar o BOU para "Não" ou ao mudar
    a diligência para "Permaneceu na OPM: Sim".
    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
2026-09-25 IA do Mov. Sociais tenta de novo quando o Google está sobrecarregado
    O relatório de IA de 7 dias falhava com "HTTP 503: This model is
    currently experiencing high demand", uma sobrecarga temporária do
    gemini-2.5-flash no Google, e mostrava "Verifique as credenciais".
    As 5 chamadas ao Gemini passam por chamarGemini(): em 503/500/429 ou
    falha de rede espera (3s, 6s) e tenta de novo até 3 vezes; se continuar,
    usa o modelo reserva gemini-2.5-flash-lite. Modelo inexistente (404)
    passa direto ao reserva; chave inválida e outros erros não são
    repetidos. O botão mostra o progresso e as mensagens de erro explicam o
    motivo em português.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
2026-09-25 Remove a estimativa de público de 7 dias do Mov. Sociais
    Tira o botão "Gerar Estimativa de Público (7 Dias)" e a função
    gerarEstimativaPublico (formulário de vetores, cálculo e janela do
    resultado). A previsão individual "Prever Público" do cartão de cada
    evento continua, assim como a chave config/gemini_public_key que ela
    usa. A chave config/metodo_estimativa do Firebase deixa de ser usada.
    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
2026-09-25 Prever Público atualiza as métricas do Instagram antes da previsão
    Ao clicar em "Prever Público", se o evento tem link do Instagram, o
    botão fica laranja com "Atualizando métricas...", as métricas são
    buscadas de novo e salvas no evento, e só então a IA gera a previsão.
    As métricas (curtidas e comentários) agora entram no texto enviado à
    IA, o que antes não acontecia.
    obterMetricasInstagram não devolve mais "0 curtidas / 0 comentários"
    quando a API responde com erro ou sem esses campos (limite do plano,
    post removido): devolve null e as últimas métricas salvas são mantidas.
    Claude-Session: https://claude.ai/code/se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
2026-09-25 Corrige "Gravar" que fechava a janela sem salvar o evento
    Prever Público e os relatórios de IA reaproveitam a janela de evento e
    trocam a ação do botão Gravar (fechar / copiar relatório), e a troca
    ficava valendo. Depois deles, "Agendar Evento" (manual ou por IA) e a
    edição fechavam a janela sem gravar, ou copiavam o relatório.
    prepararBotaoGravar() restaura a ação, a cor e o texto do botão ao abrir
    essas janelas.
    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
2026-09-28 Eventos novos passam por aprovação antes de aparecer no calendário
    Evento novo (Agendar Evento manual ou por IA) cadastrado por quem não é
    aprovador vai para eventos_pendentes e não aparece no calendário, nos
    relatórios nem nos alertas. Os aprovadores (luiz.silva07@pm.pr.gov.br e
    luizf.0120@gmail.com), ao entrar no Mov. Sociais, veem o painel de
    eventos aguardando aprovação e a janela do primeiro abre sozinha,
    editável, com "Aprovar e Publicar" (vai para alertas_calendario com
    aprovadoPor) e "Rejeitar" (apaga). Eventos dos próprios aprovadores e
    edições de eventos já publicados gravam direto.
    Claude-Session: https://clau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
2026-10-14 Administradores podem apagar pastas e links da árvore de movimentos
    luiz.silva07@pm.pr.gov.br e luizf.0120@gmail.com veem uma lixeira em
    cada pasta e em cada link. Ao clicar, uma janela confirma a exclusão,
    mostrando o local e quantas pastas e links serão apagados junto. Apagar
    uma pasta apaga tudo o que está dentro dela.
    A exclusão lê a árvore atual do Firebase (não desfaz o que outra pessoa
    adicionou), guarda uma cópia do item em lixeira_arvore, remove as
    estrelas dos itens apagados e redesenha a árvore mantendo as pastas
    abertas, os vistos e os rankings atualizados. database.rules.json passa
    a permitir gravar estrutura_arvore só aos dois administradores.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
2026-10-14 Remove o agendamento de eventos pela árvore (ícone 📅)
    Os nós da árvore não mostram mais o 📅. Eventos passam a ser agendados
    só pelo "Agendar Evento" do calendário, que passa pela aprovação dos
    administradores. Saem também a marcação do 📅 e o balão "AGENDA DE
    EVENTO". O post-it (💬) continua. Eventos já agendados pela árvore no
    dia continuam visíveis e editáveis pelo cartão do calendário.
    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
2026-10-14 Seção "Movimentos em Andamento" abaixo do calendário
    Lembretes de movimentos em andamento, abaixo dos botões do calendário.
    Cada um vira um balão com o texto na cor escolhida (verde, amarelo ou
    vermelho; o formulário sempre começa no verde), do mais novo para o mais
    antigo, com o botão "Adicionar Movimento" sempre embaixo. Ficam em
    movimentos_andamento no Firebase e aparecem para todos em tempo real.
    Cada balão tem um × para remover, com confirmação.
    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
2026-10-14 Administradores podem editar pastas e links da árvore (lápis ✏️)
    luiz.silva07@pm.pr.gov.br e luizf.0120@gmail.com veem um lápis ao lado
    da lixeira em cada pasta e link. Ele abre a janela de item em modo
    edição, já preenchida: nas pastas, nome, cor e símbolo; nos links,
    plataforma e URL (o texto do cartão é recalculado).
    Renomear uma pasta ou trocar uma URL leva estrelas, vistos de hoje,
    post-its de hoje e a contagem da semana para o caminho novo, e a pasta
    continua aberta. Não deixa nome vazio, com ">" ou repetido no mesmo
    lugar, nem URL repetida na pasta. MOVIMENTOS e NOTÍCIAS têm o nome
    travado (o código depende dele), mas símbolo e cor podem mudar. A
    janela de adicionar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
2026-10-14 Neon pulsando nos "Movimentos em Andamento"
    O título fica branco, com 🎯. O texto dos lembretes fica maior (16px),
    mais forte e com um leve brilho na própria cor. Cada balão ganha um
    contorno neon na cor do texto que acende e apaga devagar (3s em cada
    sentido); com "reduzir animações" ligado no sistema, fica aceso sem
    piscar. A lista ganhou espaço em volta para o brilho não ser cortado.
    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
2026-10-14 Letras dos "Movimentos em Andamento" sem brilho, neon só no contorno
    Tira o text-shadow do texto dos lembretes, que deixava as letras
    ofuscadas, e desenha o texto e o × por cima do neon do contorno
    (z-index 1), para o brilho interno não passar sobre as letras. O
    contorno neon e o acende-apaga continuam iguais.
    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
2026-10-22 Adiciona canhão de brinquedo em OpenSCAD com reparo de coroa e rosca sem fim
    Azimute 72:1 (mesa giratória sobre BBs + 608) e elevação 60:1, com escalas
    gravadas em graus, ponteiros e tambor micrométrico nas manivelas. Cano simples
    provisório; mecanismo de disparo fica para depois.
    Claude-Session: https://claude.ai/code/session_01MAT7JDWnQKaVFjLoye9FdL
2026-10-22 Adiciona STLs prontos de todas as peças e pacote zip
    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
2026-10-22 Canhão v2: redução 100:1, escalas 10°/5°/2,5° e manivelas revisadas
    - coroas de 100 dentes (az módulo 1,5 Ø153; el módulo 1 Ø102)
    - escalas: número a cada 10°, traço a cada 5°, ponto a cada 2,5°
    - manivelas com mancal externo, tambor de 36 marcas (0,1°),
    cubo travado por pino e punho giratório
    - rosca de elevação mais alta para a manivela passar sobre a de azimute
    STLs ainda da v1; serão regenerados após as checagens de colisão.
    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
2026-10-22 Deixa artilharia.scad 100% ASCII para colar/abrir sem erro de codificação
    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
2026-10-22 Canhão v3 (em andamento): 4°/volta, tambor graduado, travas em E e lançador de mola
    - coroas de 90 dentes: 1 volta = 4°, 1/4 de volta = 1°; tambor com 0,1°
    - travas em "E" impressas no lugar dos pinos de filamento
    - lançador: pistão com cremalheira, pinhão mutilado, rosca de armar
    autotravante, gatilho lateral e cano carregado pela boca
    Checagens de colisão do lançador ainda em execução; STLs serão regenerados.
    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
2026-10-22 Ajusta fase da coroa de elevação de 90 dentes para engrenar com a rosca
    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
2026-10-22 Canhão v3: STLs, imagens e README do lançador de mola e da pontaria 90:1
    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
2026-10-22 Revisão para PETG: folgas, encosto axial das roscas, batentes e reforços
    - folgas separadas por tipo de encaixe (fixo, gira, desliza, axial, dentes)
    - roscas encostam nos mancais (0,15 mm): elimina até 1,7 graus de jogo
    - batente do pistão vira degrau interno com anel amortecedor; tampa traseira removível
    - pino do punho Ø8 oco para alma M3; batentes de elevação em -12 e 82 graus
    - gatilho 6 mm, orelha com 6 mm de rosca, mola de lâmina mais longa
    STLs serão regenerados após as checagens.
    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
2026-10-22 STLs e README da revisão para PETG (tampa, amortecedor, batentes, folgas)
    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
2026-10-22 Troca a manivela de armar por volante compacto (batia na manivela de elevação a 82°)
    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
2026-10-22 Base em cruz com pernas e anel oco; mesa com janelas de alívio; tabela de peso em PETG
    Base de 651 g para 369 g (maciço) e mesa de 209 g para 150 g, mantendo a pista
    das esferas, a sede do 608, os mancais e a escala intactos.
    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
2026-10-22 Adiciona projéteis estilo morteiro (cintas de guia + ogiva tangente) e porta-munição na montagem
    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
2026-10-22 v4: sem parafusos nem rolamento comprado; base sem pés; projéteis alinhados
    - anéis de pista impressos com dentes de encaixe (BBs entre canais em V) no lugar do 608
    - rebites de pressão (carro), baionetas (tampa e cano) e pino com trava (gatilho)
    - pernas e pés de borracha removidos; projéteis a 25 graus iguais nos dois lados
    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
2026-10-22 Pontaria 120:1 (3 graus por volta): coroas de 120 dentes e tambor 0-1-2
    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
2026-10-22 STLs e README da versão 3 graus/volta com punho de clique (todas as checagens passaram)
    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
2026-10-22 Coroas em setor e base em bandeja (em verificação)
    - azimute: dentes só em +-60 graus, curso +-50 com batentes; o batente da mesa é o ponteiro
    e a escala -50..+50 fica gravada na aba da parede da base
    - elevação: coroa em setor, faixa -20..85 graus (batentes -22/87)
    - base em bandeja rasa: mesa 10 mm mais baixa, parede em volta, piso só fora do anel
    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
2026-10-23 v7 (em verificação): mesa e carro numa peça, coroa de elevação raiada, base com casulos e plataforma vazada
    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
2026-10-23 STLs da v7 (base, mesa com carro, coroa de elevação); saem carro e rebite
    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
2026-10-23 Bochechas em treliça, raios finos nas duas coroas e capa de clique no volante de armar (em verificação)
    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
2026-10-23 Capa do volante de armar assentada acima do cubo (sem interferência)
    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
2026-10-23 Coroa de elevação: anel de arredondamento dos raios fica abaixo do pé do dente
    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
2026-10-23 STLs: mesa com bochechas em treliça, coroa de raios finos, volante com capa e punho_armar
    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
2026-10-23 Mesa: vigas entram no contrapeso (malha fechada; a STL anterior saía sem a camada grossa). STL e pesos corrigidos
    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
2026-10-23 README: verificações da v7.1 e aviso sobre a STL da mesa da v7
    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
2026-10-24 v8 (em verificação): projétil em 4 partes de 2 cores, carro separado da mesa com orelhas, garfos e cunhas 1:12, revisão de folgas
    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
2026-10-24 README v8: cunhas, projétil em 2 cores, revisão de folgas
    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
2026-10-24 Carro colado no centro da mesa (assento com espiga e chaveta); escala de azimute na mesa e ponteiro-batente na base; sem cunhas
    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
2026-10-24 Mesa: ressaltos de batente entram 1 grau na faixa (malha fechada); README v9; sai a cunha
    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
2026-10-24 README: rolamento conferido com BB de 5,95 mm (corte, números e dica de montagem)
    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
2026-10-24 Ponteiro de azimute separado (encaixa no pilar depois da mesa); guia de montagem passo a passo
    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
2026-10-24 Zip com as peças críticas (100% de preenchimento)
    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
2026-10-24 Rolamento de esferas de contato em 4 pontos: anel interno (mesa) dentro do anel externo em 2 metades (base), BBs presas entre eles; vão de 1 mm entre mesa e base
    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
2026-10-24 STLs do rolamento novo (parcial); saem os anéis de pista antigos
    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
2026-10-24 v10: rolamento de esferas de 4 pontos verificado; STLs, README, imagens e zips atualizados
    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
2026-10-24 v11 (em verificação): tudo reduzido a 77% (base de 15 cm); folgas, BBs de 6 mm e mola 0,8x9x75 em tamanho real
    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
2026-10-24 v11: STLs reduzidos (base de 150 mm), imagens na nova escala, peso e balistica atualizados no README
    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
2026-10-25 v11: travas E com 1,0 mm reais (5 camadas) no canal de 1,24 mm; comentarios do scad atualizados
    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
2026-10-25 v11 verificada: 36 checagens CGAL ok na escala de 150 mm; README e zips atualizados
    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
2026-10-27 Ponteiros reorientados para impressao: agulha deitada na mesa e pino para cima (antes ficavam suspensos a 0,4 mm)
    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
2026-10-31 v13 (em verificacao): culatra inteira e cano octogonais, impressos deitados sem suporte; folgas maiores para o pistao e os projeteis ja impressos
    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
2026-11-03 v15 (em verificacao): carro virado 180 graus na mesa (cano oposto a manivela de azimute); chaveta dos 2 lados no carro
    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
2026-11-03 v15 verificada: varredura de azimute com o carro virado, livre
    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
2026-11-04 STL da travessa entre as bochechas do carro
    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
2026-11-05 CLAUDE.md: regras do projeto (nada de abas finas em balanco; medir paredes em mm reais; reaproveitar pecas impressas)
    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
2026-11-05 Anel de reparo da baioneta do cano (luva octogonal colada por fora da culatra, flange inteirica de 3 mm)
    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
2026-11-05 Anel de reparo: folga de 0,25 mm por lado, alivio nos cantos e chanfro de entrada (entra justo, sem forcar)
    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
2026-11-06 Reguas e numeros para colar sobre as escalas de azimute e elevacao
    Reguas com os mesmos tracos da gravacao (linha de 0,62 mm), numeros
    soltos de 3,9/4,2 mm vazados no contorno (uma peca por numero) e calco
    de 1,2 mm para os ponteiros. CLAUDE.md: regras de qualidade de impressao.
    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
2026-11-06 Reguas de colar vazadas: so linha, tracos e pontos (presos por haste)
    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
2026-11-06 Acabamento abaulado nas reguas e numeros de colar (reguas exportadas)
    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
2026-11-06 Numeros de colar com acabamento abaulado (STL) e zips
    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
2026-11-08 Numeros avulsos para reimprimir (-40 e -10 da mesa, 40 da elevacao)
    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
